letteryzzm/emotionbot/docs/项目版本与素材.md

# 项目版本与素材

> 2026-11-10：后续不使用 T5，输入改为电脑直连；模型选择与标定规划见[下一阶段方案](下一阶段方案-上位机情绪识别与标定.md)。以下代码整合记录保留历史来源，实时流程尚未按新方案改造。

## 当前代码与运行入口

原有未提交的视觉、戏台、总控、T5、标定、固件、测试和 PPT 生成脚本已纳入版本控制，并合并远端感知 / 决策 / 运行时。原始工作区完整保存在提交 `26802ea`，便于追溯；后续合并保留串口启动重试与中心补偿，依赖配置同时包含两套模块。

两套运行入口仍各自独立；代码归入同一仓库不代表完整真机链路已统一验收。模型、数据、原始演示素材仍在 T9。此次只做软件测试与仿真验证，未重刷固件或驱动真机。

## 整理前的版本边界（历史快照）

| 来源 | 基线 | 内容 |
|---|---|---|
| [GitHub main](https://github.com/letteryzzm/emotionbot/tree/21aab03e8e861636405590df0e3fdff7665b93ec) | `21aab03`，通过 `git ls-remote` 核实 | 固件 / 电脑端基础、感知 / 决策 / 运行时、六份项目与联调记录 |
| T9 工作树 | HEAD `e2b0061`，落后 main 六个提交，另有未提交改动 | camera、culture、lingmou、T5 EB2、标定工具、现场素材，以及既有固件 / 电脑端修改 |
| note/head | 原有笔记与此次汇入 | 学习记录、研究综述、硬件图解、协议、日志、评测报告与素材索引 |

第一轮先发布文档，保留原 T9 工作树的未提交代码；随后用户要求把原有未提交内容一并提交，因此完成上述代码合并。表中的提交号只描述整理前状态。

## Demo 原件

以下均相对 T9 项目根目录；时长取自现有文件的 ffprobe 元数据。

| 文件 | 时长 / 大小 | 内容与去向 |
|---|---|---|
| `ppt/assets/V1_主视频.mp4` | 65.876 s / 32.8 MiB | 主 Demo；完整视频留 T9，封面用于 README |
| `ppt/assets/V2a_红脸.mp4` | 3 s / 519 KiB | 红脸动作；精选副本 [opera-red.mp4](media/opera-red.mp4) |
| `ppt/assets/V2b_黑脸.mp4` | 3 s / 537 KiB | 黑脸动作；精选副本 [opera-black.mp4](media/opera-black.mp4) |
| `ppt/assets/V2c_蓝脸.mp4` | 3 s / 666 KiB | 蓝脸动作；精选副本 [opera-blue.mp4](media/opera-blue.mp4) |
| `ppt/assets/V5_学你.mp4` | 14 s / 4.1 MiB | 表情模仿；完整视频留 T9，封面用于 README |
| `ppt/IMG_0278.MOV` 等 | 最大约 2.3 GiB | 原始拍摄，不随笔记或 README 复制 |
| `ppt/08灵眸战队.pptx`、`08灵眸战队.pptx` | 两份现存演示稿 | 原件均保留；没有假定两份相同 |

`ppt/build_deck.js` 中“看见你”（V3）和“听你说”（V4）仍为视频预留位；不把预留位描述为已完成录像。

## README 配图来源

精选图片直接复制已有素材，没有生成替代实物图或改动原件。

| 当前文件（`docs/media/`） | 来源（`ppt/assets/`） |
|---|---|
| `demo现场.jpg` | `V1_cover.jpg` |
| `真机.jpg` | `P3_真机.jpg` |
| `控制台.jpg` | `slot/S5.jpg` |
| `组装.jpg` | `slot/P9.jpg` |
| `标定.jpg` | `slot/P10.jpg` |
| `红脸.jpg` / `黑脸.jpg` / `蓝脸.jpg` | `V2a_红脸_cover.jpg` / `V2b_黑脸_cover.jpg` / `V2c_蓝脸_cover.jpg` |
| `表情模仿.jpg` | `V5_学你_cover.jpg` |

## 大文件存放

本机 T9 挂载为 `/Volumes/Robotics`，项目位于 `/Volumes/Robotics/projects/head`。

| 位置 | 保存内容 |
|---|---|
| `ppt/` | 原始 MOV、剪辑、图片原件与演示稿，约 2.5 GiB |
| `models/` | 模型权重，约 590 MiB |
| `emo_bench/data/` | 评测数据，约 541 MiB |
| `upstream/` | 原作者 CAD、参考模型和下载包，约 417 MiB |
| `outputs/` | 渲染、缓存、日志等，约 204 MiB |
| `print_package/` | STL、3MF 和补打包，约 134 MiB |
| `机器人头_打印包.zip` | 完整打印压缩包，约 58 MiB |
| `.venv/` | 本机运行环境，约 364 MiB |

这些路径均保留原位。note 只新增文档、必要的小图和 HTML；评测报告中的视频链接回 T9，需要挂载磁盘。此清单不承诺文件已上传到 GitHub Release。

整理前的 README、四份被更新的 note 文件、原始 Git 差异和校验清单备份于同盘 `projects/head-整理备份-2026-11-09/`。它是回退副本，不是跨磁盘备份。
