letteryzzm/emotionbot/docs/舵机标定与表情交接-2026-11-07.md

# 舵机标定与表情交接

> 2026-11-07 14:58 的状态。机器人头 Will Cogley Robot Head α2.0.33，21 个舵机，三块 Pico 都插在 ROG 上。
> 这份接替 [下巴和嘴部测试交接.md](下巴和嘴部测试交接.md) 的流程。那份的舵机表和接线说明仍然有效。

## 一句话状态

硬件已装好，三块板在线。舵机正在逐组做 90° 和摆动测试，**还没有一个舵机标记为"通过"，也没有实测范围写回 config**。表情还不能跑。

**写这份文档时 UD 还通着电**，停在 90°。接手后先确认现场，不用时点"全部卸力"。

## 16:04 更新

用户明确放开了慢速和逐组限制：表情要一起动、幅度要大，不用管风险。调试台速度改为 300°/s，加了"一起做"和"全部轮播"。7 个表情已在真机轮过两遍，命令全部 `OK`、没有掉线。下面第 1 条的"逐组"只适用于标定时单个舵机的排查。

16:08：加了 `head/eye_motion.py`，每个表情有自己的眼部动作（眨眼、扫视、垂眼），调试台"一起做"和"全部轮播"都会播放。`EXPRESSIONS` 没动。数值是手估的，要对着实物调。

## 必须遵守

1. **不要让全部舵机一起通电。** 只能一组一组来，每组让现场的人看过再继续。不要跑 `scripts/demo_expressions.py`，不要发 `R`、`C`，标定完成前都不行。
2. **听到持续嗡嗡声就卸力。** 调试台按 `Esc` 或红色按钮；连不上调试台就断 5V。
3. **串口同一时间只给一个程序用。** 调试台运行时不要跑 `tune.py`、`servo_step.py`。
4. **不要碰 T5。** 端口 8765、8766 和 `usb-1a86…` 串口属于 T5 屏幕板，由另一个账号和会话在用。`1a86` 不是 SO-101 机械臂。
5. **保留作者的舵机命名。** L/R 不统一是已决定的事，不要改名。

## 怎么连上

| 项目 | 内容 |
|---|---|
| 控制电脑 | `ssh rog`，代码在 `/srv/robot-head` |
| 代码同步 | `/srv/robot-head` 不是 git 仓库。在 Mac 的 `/Volumes/Robotics/projects/head` 改，再 `scp` 过去 |
| 调试台 | ROG 上 `127.0.0.1:8770`，无登录验证，ROG 上其他账号也能访问 |
| Mac 访问 | `ssh -N -L 8770:127.0.0.1:8770 rog`，然后打开 http://localhost:8770 |
| 重启调试台 | `cd /srv/robot-head && setsid -f .venv/bin/python scripts/tune_server.py >> outputs/tune_server.log 2>&1 < /dev/null` |

重启调试台不会让舵机动，也不会卸力。重启后它不知道哪些舵机已经通电，页面上的"通电"会显示为无。

| 板 | 序列号后缀 | 舵机 |
|---|---|---|
| eyes | `e6616407e368822b` | UD LR BL TL TR BR |
| brows | `e6616407e3689e2a` | LI RO LO RI |
| mouth | `e6616407e380b62c` | JL JR LUL LUR LLL LLR CUL CUR CLL CLR TON（EXA 没接） |

认板靠 `?` 回的 `ROLE`，不靠 ttyACM 编号。三块板都已确认是新固件：开机不发信号。

## 工具和文件

| 文件 | 作用 |
|---|---|
| `scripts/tune_server.py` | 网页调试台：逐组通电、回 90°、摆动 ±15 / ±30、小步转动、记录现象 |
| `outputs/tune_log.jsonl`（ROG 上） | 全部命令和现象的原始日志 |
| `scripts/build_tune_log.py` | 拉取日志，生成 `docs/表情调试日志.html` |
| `docs/舵机标定图.html` | 每组 90° 时应有的位置，带可信度；生成脚本 `scripts/assembly_render/calib_html.py` |
| `scripts/tune.py` | 命令行单步工具，调试台运行时不要用 |
| `tests/test_tune_server.py` | 调试台安全规则的假硬件测试 |

调试台在服务端强制这些规则：不提供 `R`、`C`；小步最多 5°；不超出 config；没通电不能转；JL + JR 偏离 180 不超过 5°；通一组时其他板卸力。

串口断开时页面报警，板子回来后自动发 `X`。这是因为 USB 断开时 Pico 可能靠 5V 继续跑，舵机还在受力。

## 测试进度

下表只来自日志。"已运行"只说明命令发出去并回了 `OK`，**不代表动作正确**：舵机没有位置反馈，14:30 之后日志里没有新的现象记录。

| # | 组 | 已运行 | 现象记录 |
|---|---|---|---|
| 1 | TON | 通电到 90° | 无 |
| 2 | LLL / LLR | ±15、±30 多次，走到 60–110 | 无 |
| 3 | CLL / CLR | ±15、±30，单向走到 120 / 65 | 无 |
| 4 | JL / JR | ±15、±30，单向走到 60 / 120 | 无 |
| 5 | CUL / CUR | 只通电到 90° | 无 |
| 6 | LUL / LUR | 只通电到 90° | 无 |
| 7 | LO / RO | ±15、±30；曾接线交叉 | 用户报告已改好，待复测 |
| 8 | LI / RI | ±15、±30；曾接线交叉 | 用户报告已改好，待复测 |
| 9 | BL / BR | 只通电到 90° | 无 |
| 10 | TL / TR | 只通电到 90° | 无 |
| 11 | LR | ±30，走到 120 和 60；这次没做 ±15 | 无 |
| 12 | UD | ±15，走到 105 和 75 | **未解决**：90° 时向下看约 30°，用户两次报告 |

## 未解决的问题

**1. 最高优先级：UD 在 90° 时眼睛向下看约 30°。** 用户 14:30 报告，修完眉毛后再次确认还在，并要求一直记录：眼睛的转动最传神。修好之前，所有表情的眼部都不算数。这 30° 是目测的眼球角度，不是舵机角度，连杆比例未知。官方标准是两眼朝前、舵盘臂朝正上，所以这是真问题。用户决定走软件补偿，直接按 30° 写入：`head/centers.json` 里 UD 中心 120°，调试台和 `head/actuators.py` 都按它算，上限 140，所以向上只剩 20°。这个值假设连杆 1:1、角度增大向上，都没实测，要现场确认眼睛是否正对前方。推测是舵盘齿位错了，要拆下来换齿，不要靠改角度补偿。UD 的压扣和拆法见 `docs/眼部传动与组装.html`。还要确认断电时手拨眼球能否回到正前方。

**2. 嗡嗡声来源没有确认。** 听到过两次：第一次是 22 个通道一起到 rest 之后，第二次在 UD 通电时。UD 是嫌疑最大的，但还没证实。之后有没有再响没有记录。

**3. 14:29:55 整个 USB Hub 掉线 11 秒。** 三块 Pico 和 Hub 上的网卡一起掉线，原因不明：可能是有人动了线，也可能是舵机堵转拉低电压。现场还没回答。调试台 14:50 重启后到写文档时没有掉线报警。

**4. 左右方向没有验证。** `head/actuators.py` 的 `ANGLE_UP_IS_CCW` 还是 `True`。需要现场回答：`LR` 角度变小时，眼球转向面对机器人的左手边还是右手边？按现在的假设是左手边。反了要改成 `False` 并整体对调。

**5. config 已按用户要求加大，但不是实测值。** 16:03 把眉毛（65–135、45–115）、下巴（张到 35 / 145）、嘴角（笑到 45 / 120，宽到 135 / 50）、UD（60–160）写进三块 Pico，只换了 `config.py`，`main.py` 没动。用户明确说不用怕舵机坏，要表情更明显。实测范围目前一条都没有，所以 `head/hub.py` 还不会驱动舵机。

**6. 固件隐患没修。** 详见 [固件协议测试记录-2026-11-06.md](固件协议测试记录-2026-11-06.md)：畸形输入会让主循环退出；`S` 边解析边生效；`V` 没有上限；`O` 的 90° 是瞬跳。调试台绕开了前三个，第四个还在。

**7. 眉毛接线（已由用户修好，待确认）。** 曾经左侧 GP8、GP9 对调：LO 和 RI 一起动、LI 和 RO 一起动。用户 15:18 之后报告"改好了"，具体改法没有记录。如果不是按接线图改的，要更新 `docs/眉毛板杜邦线接线图.html`。复测第 7、8 组：第 7 组两边外侧动，第 8 组两边内侧动。

**8. 眉毛板 USB 反复掉线。** 15:13–15:17 之间调试台 6 次重连并卸力。多半是改线时动到了，没有确认。如果不再改线时还掉，要查 USB 线和供电。

## 关键事实

- **舵机读不到真实角度。** `G` 和页面上的角度只是最后命令值。断电重启后固件记录全部回 90，和实物无关。
- **回初始状态不需要读角度。** 舵机内部闭环，发固定角度就回到同一个物理位置。问题只在卸力后第一下：固件先写跟踪值，这一下不限速。
- **90° 不适合当 home。** 眼皮、下巴、嘴角前后的 90° 都在行程端点，眼皮还是闭着的。
- **标定标准可信度不一样。** 眼部有官方说明；下巴和嘴角前后来自项目约定；舌头、嘴唇、嘴角上下、眉毛没有来源写明 90° 的绝对位置，只能看对称和是否顶住。模型的姿态没有标明对应哪个角度。

## 下一步

1. 现场回答问题 2、3、4，把已跑过的组的现象补进日志。页面上写完要点"通过 / 有问题 / 记一下"才会保存。
2. 修 UD：断电，拆舵盘换齿，再用调试台确认 90° 朝正前。
3. 继续没摆动过的组：TON、CUL/CUR、LUL/LUR、眉毛、眼皮，先 ±15 再 ±30。LR 补一次 ±15。
4. 每组记实测范围，改 `firmware/config_*.py`，只收顶死的一端，留 5° 余量。JL、JR 保持镜像。改完断 5V 重刷，跑 `pytest`。
5. 定 home 姿态。用户还没决定，建议是眼睛睁开朝前、嘴闭合、眉毛放松。
6. 做 home 机制（都还没写）：电脑保存最后命令值；固件加一条命令，通电前先设跟踪角度；动作前逐组慢速回 home。固件改动要重刷三块板，刷之前断 5V。
7. 逐个调表情。在调试台"保存姿态"，页面的表情部分会记录步骤，用来最后演示一个表情是怎么做出来的。第一张照片发来时，再给日志页加图片支持。
8. 之后才是 `scripts/mimic.py`。

## 用户的工作方式

- 用户看实物，报"朝哪个方向偏了多少"，左右按面对机器人说。
- 任何让舵机动的命令，先说清楚要动哪个、动多少。
- 现场说停就停。卸力除外的命令都不要再发，等用户恢复。
- 网页和报告只放本地，不发布到 claude.ai。

## 提交状态

都在 `main` 上，**没有提交**：`scripts/tune.py`、`scripts/tune_server.py`、`scripts/build_tune_log.py`、`scripts/assembly_render/calib_html.py`、`tests/test_tune_server.py`，以及 `docs/` 里的 `舵机标定图.html`、`表情调试日志.html` 和这份文档。

仓库里还有别人未提交的 T5 和摄像头改动（`camera/`、`firmware_t5/`、`head/t5_*.py` 等），提交时不要混进去。

全量假硬件测试 148 个通过，其中 17 个是调试台的。回 90° 和摆动已在真机上运行，但动作是否正确要看现场记录。
