letteryzzm/emotionbot/docs/复现计划.md

# Will Cogley 机器人头 α2.0.33 复现计划（用于机器人情感学习）

> 2026-10-14 · 代码和 CAD 在 ``，本目录只放笔记
> 背景调研见同目录 `情感计算×脑机接口×机器人调研报告.md` 第 5.3 节方案 B

## 1. 这个头是什么

| 部分 | 舵机 | 控制板 | 原版代码 |
|---|---|---|---|
| 眼睛 | 6 个：眼球左右 LR、上下 UD，四片眼皮 TL/BL/TR/BR | Eyes_Brow_Neck PCB + Pico | `eyes.py` |
| 眉毛 | 4 个：左外 LO、左内 LI、右内 RI、右外 RO | 同一种 PCB 再做一块 + Pico | `Brows.py` |
| 嘴 | 11 个：下颌 JL/JR（MG996R），上下唇 LUL/LUR/LLL/LLR，嘴角 CUL/CUR/CLL/CLR，舌头 TON；另有一路没用到的备用口 EXA | Mouth Board PCB + Pico | `Mouth.py` / `MouthMaster.py` |

一共 **21 个舵机（19 个 MG90S + 2 个 MG996R），3 块树莓派 Pico**，没有脖子。这和官方页面写的"21 actuators"一致，见 4.1。

电路板（从 EasyEDA 文件里读出来的）：
- **Mouth Board**：Pico 插座、6 组 2×3 舵机排针（共 12 路）、AMS1117-5.0 给 Pico 供电、1000µF 和 220µF 滤波电容、SS1045 二极管、两个 Qwiic（1mm 4P）接口。
- **Eyes_Brow_Neck**：Pico 排针、L78M05 稳压、SS34 二极管、**12V / 5V 供电选择**、两个 Qwiic 接口。眼睛和眉毛各用一块。
- 3 块板之间用 Qwiic 线相连，但并**不是 I²C**：嘴部 Pico 把 GP16/17 当成 2 个数字位，给眼部和眉部板各发 4 种状态。

打印文件：`BambuPrintfile.3mf` 有 8 个 plate，直接用 Bambu Studio 打开。

## 2. 原版直接拿来做情感学习的问题

1. **电脑只能发离散命令**。电脑只连嘴部 Pico，眼睛和眉毛只能收到 2 个 bit，也就是 4 种状态（睁、闭、随机动；上、下、"开心"、"生气"）。没法连续控制视线、眼皮和眉毛，也就没法做表情学习。
2. **缺 `servo.py`**。原版 `from servo import Servo` 依赖的库不在压缩包里。
3. **`Mouth.py` 跑不起来**：第 104 行的 `for` 循环体全被注释掉了，报 `IndentationError`。实际能用的是 `MouthMaster.py`。
4. `HeadControlUI.py` 把串口写死成 Windows 的 `COM16`。
5. 眼部的 `eyes.py` 里写了电位器缩放和眼皮限位修正的函数，但都没被调用（标题写着 CONDENSED BOARD VERSION，像是从带旋钮的版本删过来的）。

## 3. 我做的改造（已完成，16 个测试通过）

位置：``

```
upstream/Head_α2.0.33/   原版文件的拷贝（CAD、PCB、代码）
firmware/                新固件：三块 Pico 刷同一份 main.py，只有 config 不同
  main.py servo.py config_eyes.py config_brows.py config_mouth.py flash.sh
head/                    电脑端 Python 包
  actuators.py           22 维动作空间，u ∈ [0,1]，直接读固件 config
  client.py              自动找串口、按名字或向量下发
  expressions.py         7 种基本表情（按 FACS 的 AU 设计）+ 混合
  blendshape_map.py      MediaPipe 52 个 blendshape → 舵机（22 维向量，含没用到的 EXA）
  viz.py                 2D 卡通脸预览，没硬件也能调
scripts/demo_expressions.py  轮播表情（--viz 只画图）
scripts/mimic.py             摄像头表情模仿，--record 存 (blendshape, u) 数据
tests/                   在 CPython 里用假硬件跑固件逻辑
```

**关键改动：每块 Pico 各接一根 USB 到电脑**（用一个 USB hub），不再走 2-bit GPIO。这样硬件不用改，电脑可以连续控制全部 21 个舵机。

串口协议（115200 波特率，每行一条命令）：

| 命令 | 作用 |
|---|---|
| `?` | 返回这块板是 eyes / brows / mouth，以及它管的舵机名 |
| `S LR=90 UD=100` | 设置目标角度，超出 config 范围的会被截断 |
| `G` | 读取当前角度 |
| `V 300` | 设置最大转速（°/s），固件会做限速插值，表情过渡更自然 |
| `R` / `C` / `X` | 回到 rest / 全部 90°（装舵盘时用）/ 卸力 |

动作空间：每个舵机一个 u ∈ [0,1]。u=0 和 u=1 分别对应 config 里的角度 a 和 b，含义统一成"睁眼程度、眉毛抬起程度、张嘴程度、嘴角上扬程度……"。学习算法只需要面对一个 22 维的 [0,1] 向量。

角度范围是从原版的 poses 和 servo_limits 里取的。**每个舵机的方向和范围都要装好后对着实物再标定**，改 `firmware/config_*.py` 就行，电脑端会自动跟着变。

7 种表情的 2D 预览：`outputs/expressions.png`

## 4. 复现步骤

### 4.1 采购（全部网购，价格是估算）

**官方 BOM**（[Nilheim Notion：Robot Head α2.0.33](https://www.notion.so/nilheim-mechatronics/Robot-Head-2-0-33-1d724779b64d80568fd9cf1c7abd3e64)）：
真实感眼球（NMRobots 卖）、2 个 MG996R、19 个 MG90S、M2/M3/M4 螺丝（有的舵机要 M2.5）、约 25 个 M3 台阶螺丝、约 10 个 M4 台阶螺丝、热熔螺母、50×50×10 mm 风扇、5V 10A 电源、Pico 控制板。官方页面明确说这是**半成品项目，BOM 和设计可能有错，文档很少**。官方页面只有 BOM 和下载包，没有逐步装配说明，装配靠参考装配模型和原作者的视频。

舵机位置是我从装配模型里逐个定位出来的，和代码里的通道对得上：

| 位置 | 数量 | 型号 | 通道 |
|---|---|---|---|
| 眼睛（眼球和眼皮） | 6 | MG90S（CAD 里画的是外形一样的 SG90） | LR UD TL BL TR BR |
| 眉毛 | 4 | MG90S | LO LI RI RO |
| 嘴唇、嘴角、舌头 | 9 | MG90S | LUL LUR LLL LLR CUL CUR CLL CLR TON |
| 下颌 | 2 | **MG996R** | JL JR |

**舵机怎么选：**
- **MG90S 全部用金属齿版，180°，统一买同一家同一批。** 外形和 SG90 一样（约 23×12×29 mm），但扭矩更大，齿轮不容易打坏。
  - 打印件里有舵盘适配件，不同厂家的花键齿数和舵盘尺寸可能不一样，混买容易装不上。
  - 买 19 个加 4 到 6 个备件。买到后称一下，正品约 13 到 14 g；太轻的多半是塑料齿冒充的。
- **MG996R 用在下颌**，带动整个下巴，需要大扭矩。可以升级成 DS3218，同样是标准尺寸、扭矩更大、死区更小，下颌抖动会少一些。但官方是按 MG996R 设计的，**第一台建议先用 MG996R**。
- **不要买 270° 或连续旋转版**，也不要买数字舵机的"360°"版。
- 这类 PWM 舵机没有位置反馈，学习时靠摄像头看脸来闭环，见第 5 节 L2，所以不需要买总线舵机。
- 全部 21 个舵机都接 5V，MG996R 在 5V 下也能用（工作范围 4.8 到 7.2V）。

| 物品 | 数量 | 备注 |
|---|---|---|
| Raspberry Pi Pico（不带 W） | 3（多买 1） | |
| MG90S 金属齿 180° | 19 + 4 到 6 个备件 | 淘宝约 ¥8 到 15 一个 |
| MG996R | 2 + 1 个备件 | 约 ¥20 到 35 一个 |
| 5V 10A 电源（推荐适配器 + DC 母头转端子） | 1 | 官方要求；USB-C 只能给 5V 3A，不够用。图解见 `电源与接线.md` |
| XT60 **公头**线 1 根、XH2.54 2P 线 2 根 | — | 分别给嘴部板和眼部 / 眉部板供电。嘴部板上焊的是 XT60 母座（XT60PW-F），所以线要配公头 |
| 螺丝、螺母、热熔螺母 | 见下方螺丝清单 | |
| 50×50×10 mm 5V 风扇 | 1 | |
| 眼球 | 2 | 官方建议买 NMRobots 的真实感眼球（£25 起，经常缺货）。先用打印包第 9 盘的打印眼球代替 |
| USB hub 和 3 根 micro-USB 数据线 | 1 套 | 新方案每块 Pico 都要连电脑 |

**螺丝清单**

> 2026-10-31 更新：已经从装配模型里逐颗量过孔径，热熔螺母规格、每颗螺丝的用途和清点表见 `螺丝与热熔螺母清单.md`，以那份为准。下表保留作参考。

数据来源：规格和长度来自参考装配模型里的零件名，台阶螺丝的尺寸是我按模型实测的。

装配模型画得不全，比如右侧眉毛机构就没画。官方写的是"约 25 个 M3 台阶螺丝、约 10 个 M4 台阶螺丝"，而模型里分别只有 14 个和 4 个。所以建议购买量按模型数量的 1.5 到 2 倍给，台阶螺丝按官方数量再多买几个。

| 规格 | 模型里的数量 | 建议买 | 推测用途 |
|---|---|---|---|
| **M3 台阶螺丝（轴肩螺丝）**：螺纹 M3、长约 4 mm；轴肩直径 4 mm、长 4 mm；头部直径 6 mm、高 3 mm | 14 | **30** | 嘴部连杆、嘴唇的转轴 |
| **M4 台阶螺丝**：螺纹 M4、长约 4.5 mm；轴肩直径 5 mm、长 5 mm；头部直径 8 mm、高 4 mm（模型里的型号是 SSHE-M4-5-5） | 4 | **12** | 下颌转轴 |
| M2×6 内六角圆柱头 | 22 | 40 | 数量最多，推测用来固定 MG90S |
| M2×8 内六角圆柱头 | 2 | 10 | |
| M2.5×8 内六角圆柱头 | 8 | 16 | 穿过嘴部连杆拧进 MG90S 输出轴（已核实，不是固定 MG996R）；舵机输出轴是 M2 的话换 M2×8 |
| M3×6 内六角圆柱头 | 8 | 20 | |
| M3×8 内六角圆柱头 | 8 | 20 | |
| M3×10 内六角圆柱头 | 6 | 15 | |
| M4×6 内六角圆柱头 | 2 | 6 | |
| M4×8 内六角圆柱头 | 4 | 10 | |
| M4×16 内六角圆柱头 | 6 | 12 | |
| M4 热熔铜螺母：外径 5.6 到 6.0，长 5 到 6 mm（孔 Ø5.35，最浅孔深 6 mm） | 16 | 20 | 下颌、颧骨、TopBase |
| M4 平垫、M5 平垫 | 各 1 | 各 10 | |
| M2 热熔螺母（孔 Ø3.2）/ M3 热熔螺母（孔 Ø4.4） | 16 / 22 | 各 50 | 外径 3.5 / 4.8 到 5.0 |
| M3 普通六角螺母 | 14 | 30 | 嘴唇零件上有螺母槽，M3 台阶螺丝拧进去；槽深约 2.6 mm，尼龙防松螺母放不进 |

购买建议：
- 内六角螺丝直接买 **M2、M2.5、M3、M4 的 304 不锈钢内六角圆柱头套装盒**（每种规格都有 6、8、10、16 mm 这几个长度），比按单个规格买省事，也不怕漏。
- 台阶螺丝在淘宝搜"轴肩螺丝 / 塞打螺丝"，按上面的轴径、轴长、螺纹规格选。
- 热熔螺母的外径以打印件上的孔为准。打印件到手后先用卡尺量一下孔径再下单。
- 舵机自带的自攻螺丝和舵盘螺丝也留着，装舵盘时会用到。

舵机、Pico、PCB、元件、电源和螺丝加起来估计 **¥600 到 ¥900**，打印另算。

### 4.2 打印（找人代打）

**发给打印的人：** `机器人头_打印包.zip`（60MB）。里面有：

- `BambuPrintfile.3mf`：原作者已经分好盘、设好参数，对方有拓竹打印机就直接用这个。
- `STL/`：按盘分目录，每个零件一个文件，已经摆好打印方向。文件名格式是 `零件名__x数量__材料.stl`，对方用别的打印机也能打。
- `预览图/`：每个盘的效果图，用来核对。
- `打印说明.txt`：材料、参数和各盘内容。

| 盘 | 内容 | 件数 | 材料 |
|---|---|---|---|
| 1 外壳 | 后盖、前后格栅 | 3 | PLA 白 + 灰 |
| 2 嘴部机构 | 上下颌座、嘴唇、连杆 | 27 | PLA |
| 3 主框架 | 头骨框架，153×156×180 mm，最大件 | 1 | PLA |
| 4 眉毛 | 眉毛主体和连杆 | 13 | PLA |
| 5 眉毛软件 | 2 个软件 | 2 | **TPU，必须用软料** |
| 6 框架附件 | 颧骨、风扇支架 | 2 | PLA |
| 7 眼部机构 | 底座、眼皮、连杆、舵盘适配件 | 30 | PLA |
| 8 牙齿舌头 | 牙齿、牙龈、舌头，层高 0.1 mm | 5 | PLA 白 + 粉 |
| 9 补充 | 眼球 ×2（如果不买官方眼球就打）、额头装饰条 ×1（可选） | 3 | PLA 白，层高 0.1 mm |

- 参数：层高 0.2 mm，6 层墙，25% 填充，树状支撑。
- 实体体积约 880 cm³，耗材估计 0.8 到 1 kg。
- **第 9 盘不在原作者的 3mf 里**，因为官方用的是买来的眼球。我从装配模型里导出了眼球的外形（直径 32 mm 的半球），可以打印出来代替。
- 装配模型下颌两侧的两个方块就是 MG996R。还有一个直径 21 mm、厚 2 mm 的圆片，也是外购件，没有放进打印包。

### 4.3 电路板：在嘉立创下单，自己焊

从 EasyEDA 文件里核对出来的供电路径：

- **嘴部板**：XT60 输入 **5V** → SS1045 二极管 → 12 路舵机电源；同时经过 AMS1117 → 跳线 → Pico。
- **眼部 / 眉部板**：XH 2P 输入 VIN → SS34 二极管 → 6 路舵机电源；同时经过 L78M05 → Pico。舵机电源**直接接在 VIN 上**，所以虽然板上写着 12V Select，**也只能接 5V**，接 12V 会烧舵机。
- 三块板都接同一个 5V 电源。Pico 同时插着 USB 也没问题，Pico 内部的 VBUS 有二极管隔离。

#### 下单 PCB（嘉立创）

文件在 `pcb/`，有两个 `.epro` 工程，外加一份合并好的元件 BOM。

| 板子 | 尺寸 | 数量 | 规格 |
|---|---|---|---|
| Eyes_Brow_Neck（眼眉板） | 26.7 × 62.5 mm | 需要 2 块（眼睛、眉毛各 1 块） | 双层板 |
| Mouth Board（嘴部板） | 72 × 55 mm | 需要 1 块 | 双层板 |

两块都是 10×10 cm 以内的双层板，打样很便宜，嘉立创经常有免费打样券。每种起订 5 块，多出来的当备件。

步骤：
1. 安装**嘉立创 EDA 专业版**（客户端，或网页版 pro.lceda.cn），登录嘉立创账号。
2. 用"文件 → 打开 / 导入"打开 `.epro`，进入 PCB 页面，先跑一遍 DRC 设计检查。
3. 选顶部菜单的"下单 → PCB 下单"，会直接跳到嘉立创下单页并自动带上制板文件。也可以选"导出 → PCB 制板文件（Gerber）"，再到 jlc.com 手动上传。
4. 下单参数：
   - 层数 2，FR-4，板厚 1.6 mm，铜厚 1 oz，数量 5，不需要拼板。
   - 表面处理选有铅喷锡，手焊最好上锡；无铅也可以。阻焊颜色随意。
   - **不要选 SMT 贴片**，自己焊。
   - 原因：板上元件几乎都是嘉立创的"扩展库"器件，每种扩展器件要单独加换料费，贴片反而比自己焊贵很多。
5. 两个工程分开下单，各 5 块。

#### 买元件（立创商城）

用 `pcb/立创商城BOM_3块板合计.csv`，已经按"2 块眼眉板 + 1 块嘴部板"把数量合计好，也加了备件。在立创商城（szlcsc.com）搜立创编号加入购物车，或者用"BOM 配单"上传这个文件。

表里"必需 = 否"的可以不买：
- 原版两板互联用的 1 mm 接口，本方案用不到。
- 指示灯和它的电阻，只是电源指示。
- 眼眉板上的 L78M05 和它的钽电容，只在接 12V 时用。

几个和原版不同的地方：
- **眼眉板的 Pico 插座**：原版用的是 1x20 排针，Pico 要直接焊上去。我改成 1x20 **排母**，配带排针的 Pico H，坏了可以直接拔下来换。排母在淘宝买就行。嘴部板原版就是排母，不用改。
- **眼眉板的供电选择**：板上有两个不放元件的 0805 焊盘，C11 标着"12V Select"，C12 标着"5V Select"。
  - 不是电容，是选择输入电压的跳线。
  - 本方案接 5V，**C12 用焊锡短接（或焊一个 0805 0Ω 电阻），C11 空着**。
  - 不短接的话，板子不会给 Pico 供电。插着 USB 时还能用，拔掉 USB 就不工作了。
- **嘴部板的 BOARD POWER**：一个 2P 排针，插上跳线帽，板子才会给 Pico 供电。

Pico 同时接板子电源和 USB 是安全的。Pico 板载有一个 VBUS 到 VSYS 的二极管，板子的 5V 不会倒灌回电脑的 USB 口。

**焊接难度：可以自己焊。** 贴片元件大多是大封装：

| 难度 | 元件 |
|---|---|
| 简单 | 插件排针 / 排母、拨动开关、XT60、XH 接口；SMD 电解电容（6.3 mm 和 10 mm）；SOT-223 的 AMS1117；TO-252 的 L78M05；SMB / SMA 二极管；1206 电阻 |
| 中等 | 0805 电容 ×2、钽电容（**注意极性**）、0603 指示灯（可以不焊） |
| 不用焊 | 两个 1 mm 间距的 SH 4P 接口（CN1、CN2）：只用于原版两板互联，新方案每块 Pico 各接一根 USB，用不到 |

工具：尖头烙铁、0.6 到 0.8 mm 焊锡丝、助焊膏、镊子、万用表。焊完先**不插 Pico、不接舵机**，用万用表量 5V 和 GND 之间没有短路，再上电测舵机电源和 Pico 供电的电压。电解电容、钽电容和二极管都有极性，按丝印方向焊。Pico 建议用排母插接，坏了方便换。

### 4.4 刷固件和调试（按这个顺序，不要一次装完再上电）

```bash
source /Volumes/Robotics/env.sh && cd /Volumes/Robotics/projects/head
# 1. 每块 Pico：按住 BOOTSEL 插 USB，把 MicroPython 的 .uf2 拖进去
# 2. 刷新固件（一次只插一块）
firmware/flash.sh eyes      # 再分别刷 brows、mouth
# 3. 装舵盘之前：发 C 让全部舵机转到 90°，在 90° 位置装舵盘和连杆
.venv/bin/mpremote connect auto repl   # 然后输入 C 回车
# 4. 逐个舵机标定方向和范围，改 firmware/config_*.py 后重刷
# 5. 三块都插上，跑表情轮播
.venv/bin/python scripts/demo_expressions.py
```

## 5. 情感学习路线

| 阶段 | 做什么 | 依赖 | 对应工作 |
|---|---|---|---|
| L0 | 手工表情 + 2D 预览 | 已完成 | — |
| L1 表情模仿 | 摄像头看人，MediaPipe 出 blendshape，手写映射驱动舵机 | `scripts/mimic.py`，需要装 `.[vision]` 并下载模型 | 报告 5.3 方案 B |
| L2 学习自我模型 | 让机器人随机动舵机（motor babbling），另一个摄像头拍**它自己的脸**跑 MediaPipe，得到 (u, blendshape) 数据对。训练逆模型 blendshape → u，替换手写映射 | 第二个摄像头对准机器人 | Columbia Eva / Emo（Science Robotics 2024）的核心做法 |
| L3 感知到表达的闭环 | SenseVoice / emotion2vec（语音）+ 人脸情绪识别 → LLM 决定回应的表情和强度 → 机器人头 | 报告第 2、3 节的模型 | 调研报告里提到的"闭环评估"空白 |
| L4 用人的反馈优化 | 人对表情打分或做两两比较，用偏好学习或 RL 优化表情；进阶版把 ErrP 当奖励 | L3 + 用户实验 | HAPI；报告课题 1 |
| L5 提前预测表情 | 根据人脸前几百毫秒的变化，预测对方马上要笑，提前同步笑 | L2 的逆模型 + 时序模型 | Emo 的"提前约 840ms 预测微笑" |

**建议的第一个小目标**：做完 L1 和 L2，对比"手写映射"和"学到的逆模型"在表情模仿上的误差。评价方式是用 MediaPipe 分别处理人脸和机器人脸，比较两边 blendshape 的距离。这一步数据自己能采，不依赖别人，结果也容易量化。

## 6. 还没确认的事

- 舵机型号和数量已经和官方 BOM 对上（见 4.1）。官方没有逐步装配说明，装配只能看参考装配模型和原作者的视频。
- 供电已经从网表核对过（见 4.3）：三块板都用 5V。
- `EXA` 这一路在原版里没用到，不知道接的是什么。
- 新固件和 blendshape 映射只在电脑上用假硬件测过，`mimic.py` 还没在真摄像头上跑过。
- 许可证：Nilheim 页面说可以自由使用和修改，但没写具体协议。发论文或开源前要确认。

## 7. 待重打印（找朋友打）

| 日期 | 零件 | STL | 打几个 | 备注 |
|---|---|---|---|---|
| 2026-11-01 | 眼皮舵盘 4xTopLidHorn | `print_package/STL/plate7_Eyes/4xTopLidHorn__x4__PLA-灰.stl` | 3（1 个补 + 2 个备用） | 装眼部时弄坏 1 个。舵盘薄，建议 100% 填充 |

| 2026-11-01 | 颈部支架（自己画的，原版没有） | `print_package/给朋友打印_2026-11-01/NeckStand_颈部支架_x1.stl` | 1 | 底板平放，加 brim；用 2 根扎带穿立柱上的孔固定到头骨框架底面横梁 |
| 2026-11-01 | 官方眼球（EyeMech ε3.2 里的 Component74） | 同目录 `Eyeball_官方_x2.stl` | 2 | 白色，0.1 mm 层高 |
| 2026-11-01 | 舵机尺寸测试块 ServoSizingPlate | 同目录 | 1 | 测眼部舵机座的松紧 |

整包（含打印说明、预览图）：`print_package/给朋友打印_2026-11-01.zip`
