letteryzzm/emotionbot/docs/表情标定闭环.md

# 表情标定：调整、保存、重启与标签调用

2026-11-11：现有调试台已支持分组叠加控制、七类表情持久化、加载预览、重放和情绪标签 API。标定台是此流程的唯一串口所有者；识别模块通过 HTTP 调用它。无需 T5。

软件流程已经可运行，真实机器的七类表情仍需要人工调整和确认。历史日志、旧版预设及仿真姿态不会自动成为真机标定。

> 2026-11-13 当前状态：按用户明确要求，LLR 已恢复普通手动标定，可单独、成对或加入自选组测试；EXA 仍禁用。历史临时隔离和声音观察见 [LLR 交接](LLR-90度异响排查-2026-11-11.md)。权限恢复不等于机械验收通过。

## 启动

在项目根目录运行，浏览器访问 `http://127.0.0.1:8770`：

```bash
# 仿真：不打开串口，不修改真实中心配置
.venv/bin/python scripts/tune_server.py --sim

# 真机：先关闭 hub、app.run、tune.py 等其他串口控制程序
.venv/bin/python scripts/tune_server.py
```

真机启动只读取板子的控制角度，不自动通电、不加载动作。点击“通电并手动调节”“仅做 90° 检查”“慢速重放”等动作按钮才发送动作。设备断开后重新接入时会自动卸力。

从 Mac 操作 ROG 上的服务：

```bash
ssh -N -L 8770:127.0.0.1:8770 rog
```

然后在 Mac 打开同一地址。ROG 部署目录是 `/srv/robot-head`。服务只监听本机回环地址，使用 SSH 转发访问。

2026-11-11 已在 ROG 启动 `emotionbot-calibration.service`（用户级临时服务，未设置开机自启）：

```bash
ssh rog 'systemctl --user status emotionbot-calibration.service'
ssh rog 'systemctl --user stop emotionbot-calibration.service'
# 临时服务停止或重启 Linux 后，重新创建：
ssh rog 'systemd-run --user --unit=emotionbot-calibration --property=WorkingDirectory=/srv/robot-head /srv/robot-head/.venv/bin/python /srv/robot-head/scripts/tune_server.py'
```

停止服务会中断任务并向在线板子卸力。也可以直接在 ROG 终端使用前面的 Python 命令运行。

## 标定操作顺序

2026-11-13 已换为[标定台 v2](舵机标定台-v2.md)：选择单个 / 成对 / 自选组 → 通电并手动调节 → 慢速滑块调整 → 位置与观察记录。90° 检查是可选项，人工观察不再限制滑块权限。Esc 随时卸力，连接中断触发会话超时卸力。

1. 选好本套表情参与的通道，点击“通电并手动调节”后慢速调整为中性位置；LLR 可正常加入组合，下巴必须成对。
2. 展开页面下方“七类表情库”，保存 neutral。它定义通道集合；位置记录与表情库是两份数据。
3. 继续调整同一组电机，分别保存 happy / sad / angry / fear / disgust / surprise。每类使用与 neutral 相同的通道集合。
4. 预览只显示角度，不驱动电机。结束手动会话并卸力后，可通过“慢速重放”验证已保存表情；页面设定 5 秒过渡，标签 API 仍支持强度与保持时间。
5. 使用相同文件路径重启，确认库恢复，再进行人工重放比较。页面角度来自 Pico 控制状态，没有实际轴角反馈。

修改 neutral 角度 / 通道集合或中心 / 硬件配置后，旧表情可能失效，需按提示重新标定。配置限位及已记录正式范围仍有效。旧版预设、跟踪与分组按钮不再占据新页面；对应旧接口尚保留供历史调用。

## 保存位置与备份

| 内容 | 默认路径 |
|---|---|
| 位置与观察库 | `calibration/expressions-positions.json` |
| 真机表情库 | `calibration/expressions.json` |
| 仿真表情库 | `outputs/calibration-sim/expressions.json` |
| 真机过程日志与实测范围 | `outputs/tune_log.jsonl` |
| 仿真过程日志 | `outputs/tune_sim.jsonl` |
| 真实中心配置 | `head/centers.json` |

可用 `--library PATH --log-file PATH --port 8771` 指定独立环境；重启要保持相同路径。仿真库带有 `mode: sim`，真机模式拒绝读取，防止误用。

每次保存递增 `revision`，使用临时文件和原子替换，写入失败保留旧库；并检查页面版本及磁盘变更，避免旧副本覆盖新结果。这里的版本号用于一致性检查，历史回退通过 Git 或备份完成。页面“导出表情库 JSON”可下载备份。真机标定完成后，应将此小文件和对应中心配置同步回代码仓库提交；大日志、照片原件继续归档到 T9。

## 从识别结果调用

同一服务提供 `POST /api`，需要 `Content-Type: application/json` 和 `X-Head: 1`。七类标签使用上述英文名，同时兼容旧名称 `surprised` → `surprise`。

```bash
curl -sS http://127.0.0.1:8770/api \
  -H 'Content-Type: application/json' -H 'X-Head: 1' \
  -d '{"op":"emotion","label":"happy","intensity":0.6,"transition":1.0,"hold":2.0}'
```

这条命令会实际通电并执行已保存的 happy，达到目标后保持 2 秒，再以同样过渡回到已标定 neutral。省略 `hold` 或设为 `null` 则保持目标姿态；它不是卸力命令。强度和识别置信度是不同参数，应由上层回应策略决定。

| 参数 / 操作 | 约定 |
|---|---|
| `intensity` | 0–1，默认 1；0 为 neutral |
| `transition` | 0.2–10 秒，默认 1；每 50 ms 指令步长不超过 5°，串口耗时可能使实际过渡更长 |
| `hold` | 0–30 秒或 null；数值表示保持后回 neutral，null 表示保持当前表情 |
| `revision` | 可选；页面重放携带预览版本，过期时拒绝执行 |
| `{"op":"load_expression","label":"happy","intensity":0.6}` | 只预览，结果在 `state.preview` |
| `{"op":"relax"}` | 中断动作并全部卸力 |
| `GET /state` | `busy`、`error`、板子在线情况、表情库状态与控制角度 |
| `GET /expressions.json` | 完整导出 JSON |

成功请求返回 200 与 `state`，动作异步执行；调用方需继续查看 `busy` 和 `error`。未标定、过期配置、动作忙、板子离线、非法参数返回 400 与 `error`，不会退回旧版预设。动作忙时不排队，不打断当前标定；连续识别结果应由上层合并并在空闲时提交最新有效结果。重放时若还有 neutral 集合之外的已知通电通道，会要求先卸力。

目前接通的是“手动标定 → 持久化 → 重放 → 标签 API”。SenseVoice、EmotiEffNet、LoRA 与慢层的实时接入，以及旧 hub / HeadBridge 的迁移，仍按下一阶段方案推进。

## 验证

```bash
.venv/bin/python -m pytest tests/test_pose_library.py tests/test_tune_server.py tests/test_calibration_session.py -q
```

覆盖重启恢复、加载不触发串口、原始角度不重复补偿、强度插值、保持后回中、卸力中断、离线拒绝、通道一致性、配置失效、写失败保留旧文件，以及 HTTP 保存—重启—标签调用。所有自动动作测试使用内存串口，不替代真机机械验收。
