letteryzzm/emotionbot/docs/资料导航.md

# EmotionBot 资料导航

> 整理于 2026-11-09。日期较早的计划和交接保留历史语境；当前状态应与实际代码和最近的实测记录交叉核对。

| 要做什么 | 先读 | 图解 / 补充 |
|---|---|---|
| 看项目和演示 | [项目 README](../README.md) | [版本与素材](项目版本与素材.md) |
| 下一阶段开发 | [上位机情绪识别与表情标定](下一阶段方案-上位机情绪识别与标定.md) | 不使用 T5；模型选型、快慢层规则与实施顺序 |
| 复现硬件 | [复现计划](复现计划.md)、[螺丝与热熔螺母](螺丝与热熔螺母清单.md) | [组装流程](组装流程.html)、[组装一览](组装一览图.html) |
| 焊接和供电 | [电源与接线](电源与接线.md) | [焊接流程](焊接流程.html)、[电源线焊接](电源线焊接流程.html) |
| 排查机构 | [装配核查](装配核查-可选与待测.md)、[颈部支架](../scripts/neck_stand/README.md) | [眼部传动](眼部传动与组装.html) |
| 上电和标定 | [下巴和嘴部交接](下巴和嘴部测试交接.md)、[标定交接](舵机标定与表情交接-2026-11-07.md) | [上电检查](舵机接线与上电检查.html)、[眉毛板接线](眉毛板杜邦线接线图.html)、[标定图](舵机标定图.html)、[调试日志](表情调试日志.html) |
| 理解控制 | [统一控制进程](统一控制进程.md)、[视觉模块](视觉模块-眼球跟随与距离表情.md) | [固件协议测试](固件协议测试记录-2026-11-06.md) |
| 运行灵眸 | [灵眸戏台](灵眸戏台.md) | [3D 网页渲染调研](3D机器头网页渲染-调研与方案.md) |
| 查历史 T5 实现（后续不使用） | [EB2 协议](T5屏幕与语音协议-EB2.md)、[表情同步交接](T5表情同步交接-给联合调试session.md) | [固件说明](../firmware_t5/README.md) |
| 读实验 | [情感识别模块](情感识别模块/README.md)、[实验报告](情感识别模块/06-实验报告.md) | [测评代码](../emo_bench/README.md)、[同子集对比](../emo_bench/results/same_subset.md)、[快层评测](../emo_bench/results/fast_layer.md) |

HTML 图解包含内嵌图片，下载后可直接用浏览器打开。完整研究综述在 `综述/`；个人学习批注与笔记版本以 note 仓库为主。
