letteryzzm/emotionbot/docs/情感识别模块/01-学习资源.md

# 01 学习资源

> 阅读顺序：先社区笔记 / 教程建立整体图景 → 每个模态读 1 篇综述 → 关键论文 → 跑开源实现。
> GitHub 仓库的 star、许可证、最近更新时间用 GitHub API 查过（2026-10-18）。论文里的数字都是作者自己报告的。

---

## 1. 社区笔记、课程和教程（先看这些）

| 资源 | 类型 | 覆盖 | 为什么看 | 链接 |
| --- | --- | --- | --- | --- |
| CMU 11-777 Multimodal Machine Learning（Morency） | 课程（公开视频 + slides） | 多模态表示、对齐、融合 | 融合方法的系统框架；情感识别是这门课的经典应用 | [课程主页](https://cmu-multicomp-lab.github.io/mmml-course/fall2020/) |
| Aman.ai Multimodal ML 笔记 | 社区笔记 | 11-777 的文字版整理 | 不想看视频时的替代 | [aman.ai/multimodal](https://aman.ai/multimodal/) |
| ACL 2017 Tutorial: Multimodal Machine Learning  | Tutorial | 语言 + 视觉 + 语音融合 | 比课程更短，2 小时能过完 | [ACL Anthology P17-5002](https://aclanthology.org/P17-5002/) |
| audeering/w2v2-how-to | 教程（notebook） | 用 wav2vec2 做维度情感（A/D/V） | **SER 入门最好的实操教程**，一步步讲特征提取、回归头、评测 | [github](https://github.com/audeering/w2v2-how-to)（★564） |
| emotion2vec 在 ModelScope / FunASR 的用法 | 中文教程 | emotion2vec 加载、utterance / frame 级特征、9 类模型 | 中文、直接可跑 | [阿里云开发者社区](https://developer.aliyun.com/article/1454260) · [proginn 模型页](https://www.proginn.com/w/1546030) |
| SpeechBrain 的 IEMOCAP emotion recipe | 教程 / 代码 | wav2vec2 / ECAPA 做 SER 的完整训练流程 | 学"标准训练脚本长什么样" | [speechbrain](https://github.com/speechbrain/speechbrain)（`recipes/IEMOCAP/emotion_recognition`） |
| hsemotion-onnx / EmotiEffLib 示例 | 教程（notebook） | 人脸检测 → 裁剪 → 表情 + V/A | FER 实时推理的最小可用流程 | [EmotiEffLib](https://github.com/sb-ai-lab/EmotiEffLib) · [hsemotion-onnx](https://github.com/av-savchenko/hsemotion-onnx) |
| declare-lab/conv-emotion | 代码合集 | DialogueRNN、DialogueGCN、COSMIC 等 ERC 经典模型  | **TER（对话情绪）的前 LLM 时代全景**，一个仓库全有 | [github](https://github.com/declare-lab/conv-emotion)（★1.5k，MIT） |
| MER-Factory | 工具 | 情感数据预处理、用 MLLM 自动标注、评测 | 看社区怎么搭"情感数据流水线" | [github](https://github.com/Lum1104/MER-Factory)（MIT） |

### Awesome 列表（查漏补缺用，不用通读）

| 列表 | 方向 | 备注 |
|---|---|---|
| [abikaki/awesome-speech-emotion-recognition](https://github.com/abikaki/awesome-speech-emotion-recognition) | SER | 117 条，分综述 / 数据集 / 工具 / 论文 |
| [SuperKogito/SER-datasets](https://github.com/SuperKogito/SER-datasets) | SER 数据集 | 最全的 SER 数据集表，含语言、规模、许可 |
| [EvelynFan/AWESOME-FER](https://github.com/EvelynFan/AWESOME-FER) | FER | 按会议年份列论文，**2022 年后没更新** |
| [pliang279/awesome-multimodal-ml](https://github.com/pliang279/awesome-multimodal-ml) | 多模态 | 11-777 助教维护，★6.9k |

---

## 2. 综述（每个模态读一篇）

| 模态 | 综述 | 读法 |
|---|---|---|
| FER | Li & Deng, **Deep Facial Expression Recognition: A Survey**, IEEE TAC 2020（[arXiv 1804.08348](https://arxiv.org/abs/1804.08348)） | 重点看数据集表、静态 vs 动态、身份 / 姿态 / 光照这些干扰因素；模型部分已过时，跳读 |
| SER | Akçay & Oğuz, **Speech emotion recognition: Emotional models, databases, features, preprocessing methods, supporting modalities, and classifiers**, Speech Communication 2020 | 读情感模型（离散 vs 维度）和声学特征部分，是理解 MFCC / eGeMAPS 基线的基础 |
| SER（新） | Wagner et al., **Dawn of the Transformer Era in Speech Emotion Recognition: Closing the Valence Gap**, IEEE TPAMI 2023（[arXiv 2203.07378](https://arxiv.org/abs/2203.07378)） | audeering 那个维度模型的论文，讲清楚了"自监督模型为什么在 valence 上突然变好"——因为隐含学到了语言信息 |
| TER / ERC | Poria et al., **Emotion Recognition in Conversation: Research Challenges, Datasets, and Recent Advances**, IEEE Access 2019（[arXiv 1905.02947](https://arxiv.org/abs/1905.02947)） | 讲清楚了对话情绪和单句情绪的区别：上下文、说话人状态、情绪转移 |
| 多模态 | Baltrušaitis, Ahuja, Morency, **Multimodal Machine Learning: A Survey and Taxonomy**, TPAMI 2018（[arXiv 1705.09406](https://arxiv.org/abs/1705.09406)） | 融合部分（early / late / hybrid）是我们融合层设计的依据 |

---

## 3. 关键论文（按模态）

### 3.1 FER

| 论文 | 发表 | 为什么重要 | 代码 |
|---|---|---|---|
| **HSEmotion / EmotiEffNet** 系列 | ABAW 2022–2026 | 轻量 EfficientNet，多任务（8 类 + V/A），速度快，**是我们 FER 主力**。AffectNet-8 准确率 61.93%、7 类 64.94%；V/A 的 CCC 分别 0.594 / 0.549（AffectNet val） | [EmotiEffLib](https://github.com/sb-ai-lab/EmotiEffLib)（Apache-2.0）· [ABAW-10 论文](https://arxiv.org/abs/2603.12693) |
| POSTER / POSTER++ | ICCV 2023 workshop / PR | 静态 FER 刷榜代表，RAF-DB 92% 左右 | [POSTER](https://github.com/zczcwh/POSTER) |
| **OpenFace 3.0** | 2025 | 一个模型出 landmark + AU + gaze + 情绪；AU 是可解释特征 | [github](https://github.com/CMU-MultiComp-Lab/OpenFace-3.0)（**仅限非商业学术**）· [arXiv 2506.02891](https://arxiv.org/abs/2506.02891) |
| **DFEW** | ACM MM 2020 | 动态 FER 的标准数据集：16,372 个电影片段，7 类，5 折，报 UAR / WAR | [arXiv 2008.05924](https://arxiv.org/abs/2008.05924) · [官网](https://dfew-dataset.github.io/) |
| **MAE-DFER** | ACM MM 2023 | 视频自监督预训练做动态 FER，DFEW 上比监督基线 UAR 高 6.3 个点 | [github](https://github.com/sunlicai/MAE-DFER)（MIT） |
| **DFER-CLIP** | BMVC 2023 | 用 CLIP + 文本描述做动态 FER，代表"视觉语言模型"路线 | [github](https://github.com/zengqunzhao/DFER-CLIP)（MIT）· [arXiv 2308.13382](https://arxiv.org/abs/2308.13382) |
| S4D（Static for Dynamic） | 2024 | 用静态表情数据帮动态识别 | [arXiv 2409.06154](https://arxiv.org/abs/2409.06154) |
| FER vs VLM 对比 | Frontiers in AI 2026 | 专用小模型泛化超过 VLM —— 支持"实时用专用模型" | [链接](https://www.frontiersin.org/journals/artificial-intelligence/articles/10.3389/frai.2026.1800342/full) |

### 3.2 SER

| 论文 | 发表 | 为什么重要 | 代码 |
|---|---|---|---|
| **emotion2vec** | ACL 2024 Findings | 情感专用自监督表示；只训线性层就超过通用模型；emotion2vec+ 用约 15 万小时中英伪标签数据迭代微调 | [github](https://github.com/ddlBoJack/emotion2vec)（MIT）· [arXiv 2312.15185](https://arxiv.org/abs/2312.15185) |
| **EmoBox** | Interspeech 2024 | 32 个数据集、14 种语言的统一划分；**我们的 SER 复现协议就用它** | [github](https://github.com/emo-box/EmoBox) · [arXiv 2406.07162](https://arxiv.org/abs/2406.07162) |
| **SenseVoice**（FunAudioLLM 技术报告） | 2024 | ASR + 情感 + 事件一体；非自回归，延迟极低；开源的是 Small，**README 里最强的 SER 结果大多属于未开源的 Large** | [github](https://github.com/QwenAudio/SenseVoice)（MIT） |
| Dawn of the Transformer Era in SER | TPAMI 2023 | 维度情感（A/D/V）的公开强基线 | [w2v2-how-to](https://github.com/audeering/w2v2-how-to)（模型 **CC BY-NC-SA 4.0**） |
| Interspeech 2025 自然场景 SER 挑战赛总结 | Interspeech 2025 | 70% 队伍用 WavLM、47% 用 Whisper；**语音 + 文本融合**是最一致的规律 | [论文](https://www.isca-archive.org/interspeech_2025/naini25_interspeech.html) |

### 3.3 TER（对话情绪识别 ERC 为主）

| 论文 | 发表 | 为什么重要 | 代码 / 数据 |
|---|---|---|---|
| **M3ED** | ACL 2022 | **首个中文多模态对话情绪数据集**：56 部电视剧、990 段对话、24,449 句，7 类，音视文三模态 | [github](https://github.com/AIM3-RUC/RUCM3ED) · [arXiv 2205.10237](https://arxiv.org/abs/2205.10237)（数据需向作者申请） |
| CPED | 2022 | 中文个性化情感对话数据集，ERC 榜上 BERT 类基线准确率约 51.5% | [HyperAI 榜单](https://www.hyper.ai/cn/sota/tasks/emotion-recognition-in-conversation/benchmark/emotion-recognition-in-conversation-on-cped) |
| SMP2020-EWECT | SMP 2020 评测 | 微博单句情绪 6 类（积极、愤怒、悲伤、恐惧、惊奇、无情绪）；用来练"单句分类"基线 | 评测官网申请 |
| MELD | ACL 2019 | 英文 ERC 标准集（老友记），三模态 | [arXiv 1810.02508](https://arxiv.org/abs/1810.02508) |
| GoEmotions | ACL 2020 | 英文 27 类细粒度情绪，规模大 | [arXiv 2005.00547](https://arxiv.org/abs/2005.00547) |
| **InstructERC** | 2023 | 把 ERC 改成 LLM 生成式任务 + 检索相似示例；后面一批 LLM-ERC 的起点 | [github](https://github.com/LIN-SHANG/InstructERC) |
| CoE（Clue of Emotion） | ACL 2025 | 加角色扮演、说话人识别、情绪推理辅助任务，在 MELD / IEMOCAP / EmoryNLP 上报告 SOTA | [ACL 2025](https://preview.aclanthology.org/landing_page/2025.acl-long.1148.pdf) |
| Curriculum LoRA for ERC | AAAI 2026 | 按"情绪转移难度"排序做 LoRA 课程学习 | [arXiv 2511.07061](https://arxiv.org/abs/2511.07061) |
| THOR | ACL 2023 | 用 CoT 推理隐式情感（字面没有情绪词） | [github](https://github.com/scofield7419/THOR-ISA)（Apache-2.0） |

### 3.4 多模态融合 / 中文多模态

| 资源 | 为什么重要 | 链接 |
|---|---|---|
| **MER 2023–2026 挑战赛 + MERTools** | 数据来自中文影视，**和机器人的中文用户场景最接近**；官方 baseline 提取声学 / 文本 / 视觉特征再融合，代码全开源 | [MERTools](https://github.com/zeroQiaoba/MERTools) · [MER2024 论文](https://arxiv.org/abs/2404.17113) · [MER2025](https://arxiv.org/abs/2504.19423) · [HF 数据集（需签 EULA）](https://huggingface.co/datasets/MERChallenge/MER2023) |
| **CH-SIMS v2** + MMSA | 中文多模态情感分析（极性，不是 7 类），MMSA 框架集成了十几个融合模型 | [ch-sims-v2](https://github.com/thuiar/ch-sims-v2)（网盘直接下载）· [MMSA](https://github.com/thuiar/MMSA)（MIT） |
| Emotion-LLaMA / AffectGPT | MLLM 路线的代表，作为"上限对照" | [Emotion-LLaMA](https://github.com/ZebangCheng/Emotion-LLaMA) · [AffectGPT](https://github.com/zeroQiaoba/AffectGPT) |
| Qwen2.5-Omni / Qwen3-Omni | 端到端音视频输入，作为"不做专门融合"的对照 | [Qwen3-Omni 报告](https://arxiv.org/abs/2509.17765) |

---

## 4. 数据集获取难度一览（决定排期）

| 数据集 | 模态 | 语言 | 获取方式 | 预计等待 |
|---|---|---|---|---|
| RAVDESS、CREMA-D | 音频（+ 视频） | 英 | 直接下载 | 0 |
| ESD | 音频 | 中 / 英 | GitHub 填表 | 几天 |
| CH-SIMS v2 | 三模态 | 中 | 网盘直接下载 | 0 |
| M3ED | 三模态 | 中 | 向作者申请 | 1–2 周 |
| MER2023–2025 | 三模态 | 中 | HF 签 EULA | 几天 |
| RAF-DB | 图像 | — | 邮件申请 | 1–2 周 |
| AffectNet | 图像 | — | 学术申请 | 1–4 周 |
| DFEW | 视频 | — | 签协议 | 1–2 周 |
| IEMOCAP | 三模态 | 英 | USC 申请 | 1–4 周，可选 |

**行动项：第一天就把 M3ED、RAF-DB、AffectNet、DFEW、MER 的申请全发出去**，等待期间先用 RAVDESS / CREMA-D / CH-SIMS v2 跑通流程。

---

## 5. 建议阅读和动手顺序（约 3 周）

| 天 | 内容 |
|---|---|
| 1–2 | 11-777 融合相关两讲 + Poria ERC 综述；发数据申请 |
| 3–5 | SER：w2v2-how-to 教程 → emotion2vec 论文 → 跑 SenseVoice / emotion2vec+ 在 RAVDESS 上 |
| 6–8 | FER：Li & Deng 综述 → EmotiEffLib 示例 → MediaPipe 检测 + EmotiEffNet 实时跑起来 |
| 9–11 | TER：conv-emotion 里跑一个 DialogueRNN → InstructERC 论文 → 在 CH-SIMS / M3ED 文本上试 RoBERTa 和 LLM zero-shot |
| 12–14 | 融合：MERTools baseline 读代码 → 自己写 late fusion |
| 15+ | 动态 FER（MAE-DFER / DFER-CLIP）和 LLM LoRA 上云 |
