letteryzzm/emotionbot/culture/samples/anime2_131511080.jpg

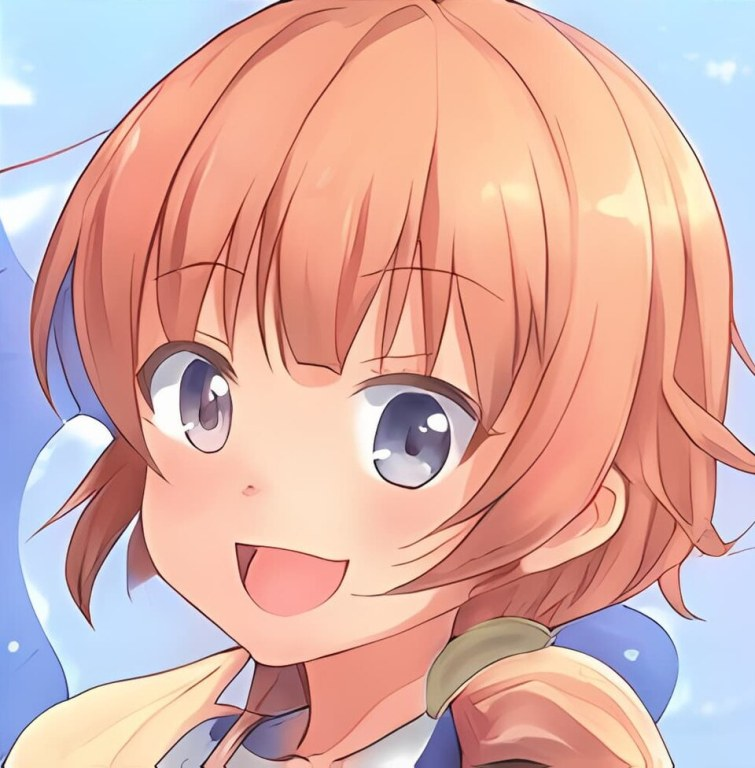
culture/samples/anime2_131511080.jpg
