letteryzzm/emotionbot/culture/samples/anime2_131511181.jpg

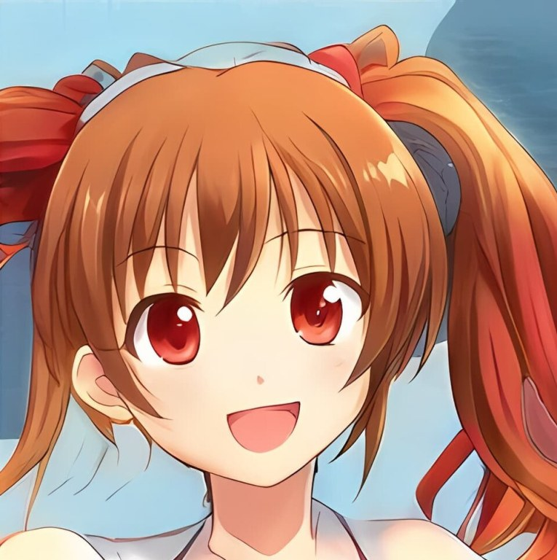
culture/samples/anime2_131511181.jpg
