letteryzzm/emotionbot/culture/samples/anime3_148975333.jpg

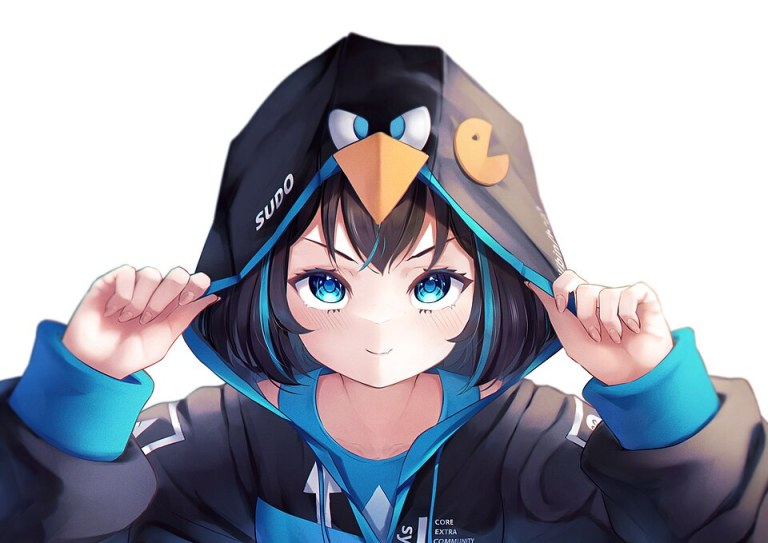
culture/samples/anime3_148975333.jpg
