letteryzzm/emotionbot/culture/samples/op4_7526800.jpg

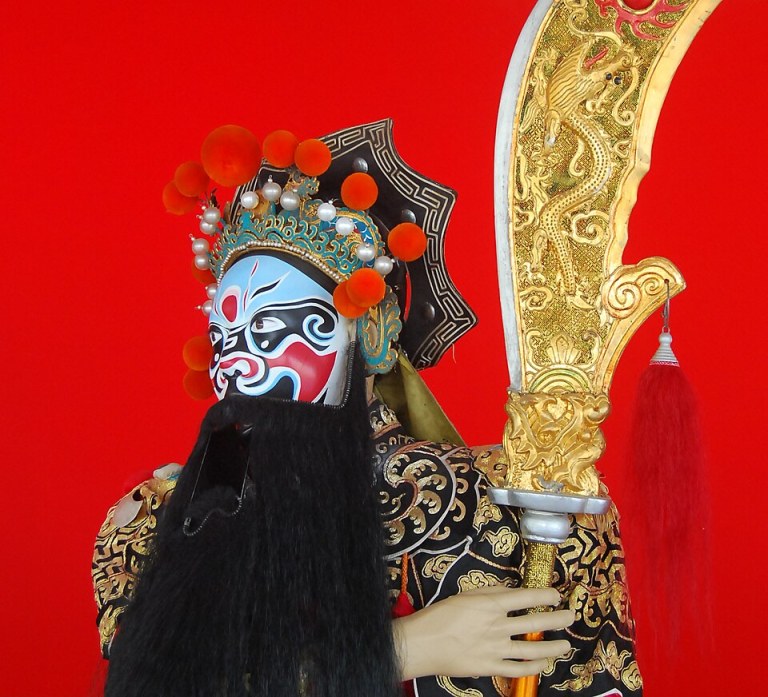
culture/samples/op4_7526800.jpg
