letteryzzm/emotionbot/culture/samples/op4_7585138.jpg

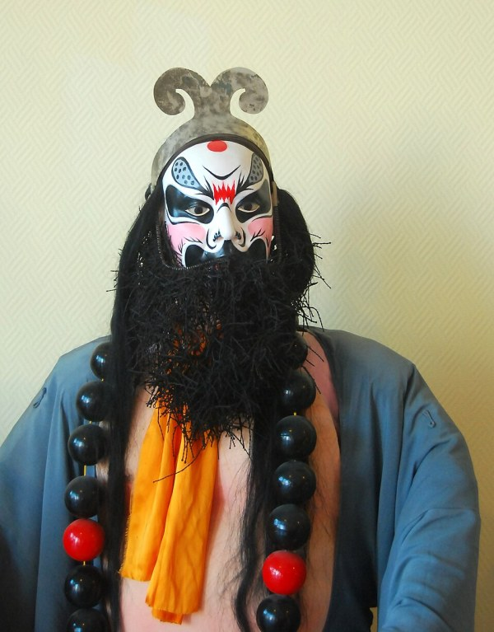
culture/samples/op4_7585138.jpg
