letteryzzm/emotionbot/culture/samples/op5_94619944.jpg

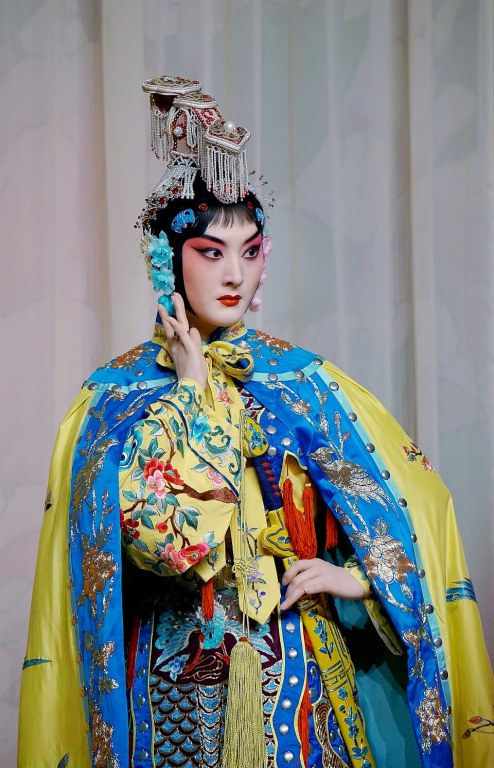
culture/samples/op5_94619944.jpg
