letteryzzm/emotionbot/culture/samples/op6_90045896.jpg

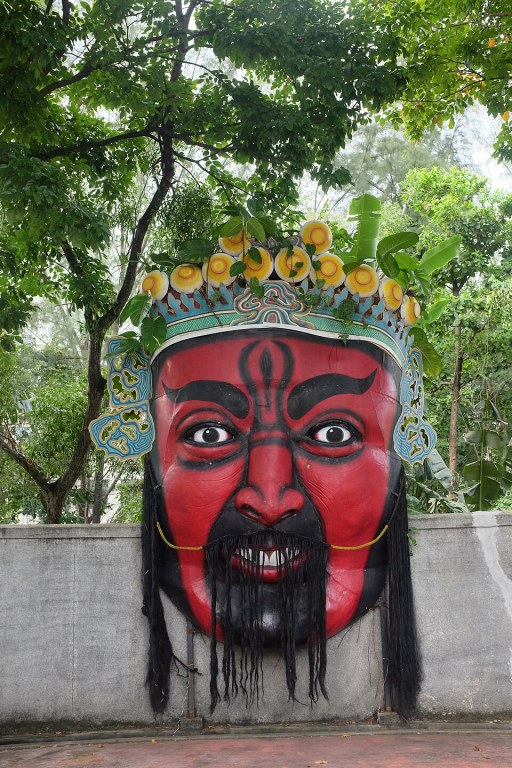
culture/samples/op6_90045896.jpg
