letteryzzm/emotionbot/culture/samples/opera3_7526534.jpg

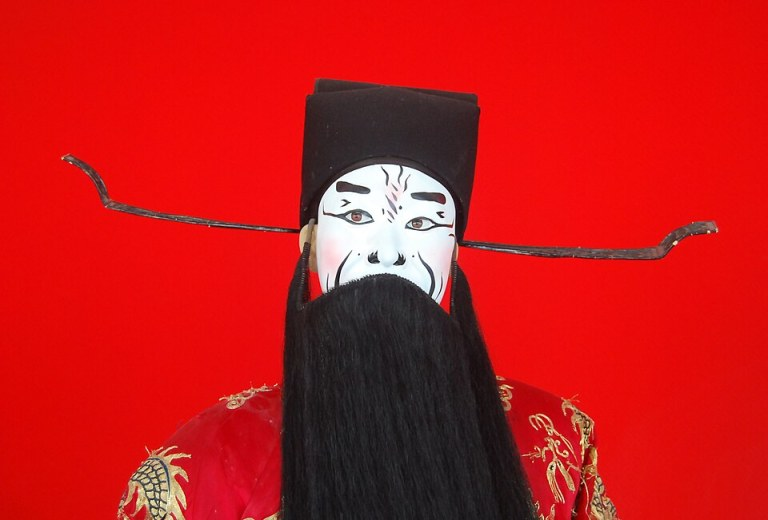
culture/samples/opera3_7526534.jpg
