letteryzzm/emotionbot/docs/media/真机.jpg

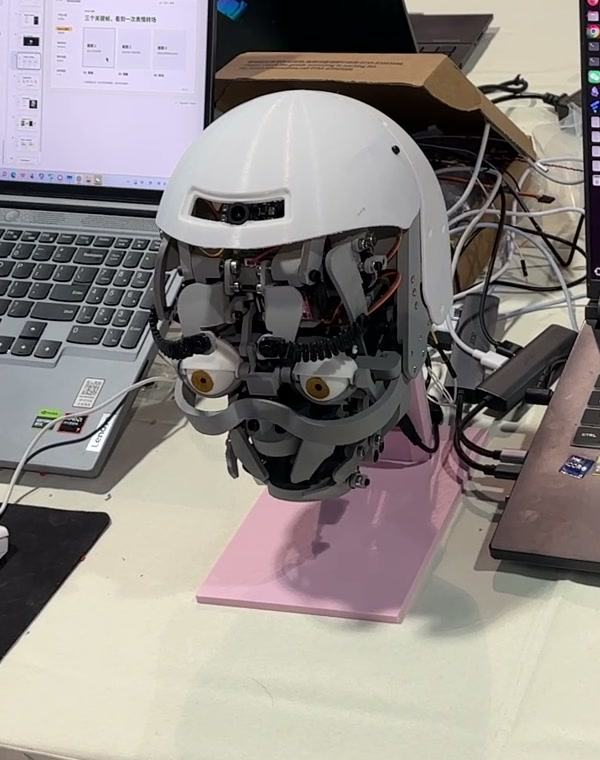
docs/media/真机.jpg
