letteryzzm/emotionbot/docs/螺丝与热熔螺母清单.md

# 螺丝与热熔螺母清单

> 2026-10-31。数据来源：从参考装配模型（Onshape 导出的 OBJ）里，逐颗螺丝量出它穿过的零件和孔径、孔深。
> 测量脚本：`scripts/hole_measure/`。
> 装配模型**画得不全**：右侧 2 个眉毛舵机（连杆都画了）、外壳和牙齿的固定、眉毛的螺丝、电路板和风扇的固定都没画。所以下面"模型数量"是下限，购买量按套装或加余量。

## 1. 热熔螺母怎么选

> 2026-11-04 复核（按网格里的圆孔逐个数）：M2 16、M3 22、M4 16。另有 3 个孔模型里没画螺丝：眼部底板 y=8 处 2 个 M3 孔，下颌座 1 个 M4 孔（大概率是舌头连杆 Part_19 的转轴）。
> **模型没画、之前漏算的（2026-11-04）**：眉毛底板 Part_4 要 M4 ×12（8 个接框架，4 个推测是台阶螺丝转轴）、M2 ×8（4 个眉毛舵机）。可选：风扇 M3 ×10（框架 6、FanBracket 4）、外壳 M3 ×14（RearPlate 10、FrontVent 4）。全部压完 M3 约 48 颗，50 颗只剩 2 颗余量；M4 必压 28 颗，30 颗剩 2 颗。

**规则：看打印件上的孔径。热熔螺母外径 = 孔径 + 0.2 到 0.5 mm；长度不能超过孔深。**

模型里所有拧螺丝的孔只有三种直径，正好对应 M2、M3、M4 三种热熔螺母：

| 规格 | 模型孔径 | 最浅孔深 | 在哪些零件上 | 模型里数量 | 买什么 | 建议买 |
|---|---|---|---|---|---|---|
| **M2** | Ø3.2 | 约 7.6 mm | TopBase、JawBase（固定嘴部的 MG90S） | 16 | 外径 3.5、长 3 到 4 mm | 50 个一包 |
| **M3** | Ø4.3 到 4.4 | 5 mm（CheekBone） | TopBase、CheekBone、SkullFrame 侧面、眼部 SnapEyemech | 22 | 外径 4.8 到 5.0、长 4 到 5 mm | 50 个一包 |
| **M4** | Ø5.35 | 6 mm（TopBase） | TopBase、JawBase（下颌、颧骨、台阶螺丝的转轴） | 16 | 外径 5.6 到 6.0、长 5 到 6 mm | 20 到 30 个 |

- 淘宝搜"**热熔铜螺母 滚花 M3**"之类。规格常写成 `M3*5*5.0`，三个数依次是 **螺纹、长度、外径**。不同店写法不一样，下单前看清楚哪一个是外径。
- 打印件到手后**先用卡尺量几个孔**。打印出来的孔通常比模型小 0.1 到 0.2 mm，量出来的孔径加 0.2 到 0.5 就是要买的外径。
- M3 不要买长度超过 5 mm 的，颧骨（CheekBone）上的孔只有 5 mm 深。
- M4 不要买超过 6 mm 长的，TopBase 上的孔只有 6 mm 深。模型里自带的 M4 热熔螺母画的是 9 mm 长，那是给 JawBase 用的（那里孔深 9 mm）。用 6 mm 的两边都能装。
- 眉毛和眼部的螺丝模型里没画，这几个模块大概率也用 M2、M3 热熔螺母，所以每种都多买，一包 50 个比较稳妥。

## 2. 螺丝清单

| 规格 | 模型里数量 | 建议买 | 用在哪（从模型里量出来的） |
|---|---|---|---|
| M2×6 内六角 | 22 | 40 | 14 颗：嘴部 MG90S 的安装耳 → TopBase / JawBase 里的 M2 热熔螺母；8 颗：下颌连杆 → **MG996R 舵盘**（直接拧进舵盘孔） |
| M2×8 内六角 | 2 | 10 | 两个叠在一起的 MG90S 安装耳 → TopBase |
| **M2.5×8** 内六角 | 8 | 16 | 穿过嘴部连杆，**拧进 MG90S 的输出轴**（当舵盘螺丝用），见下面说明 |
| M3×6 内六角 | 6 | 15 | 某个外购件（模型里叫 Component2）→ TopBase |
| M3×8 内六角 | 8 | 20 | 4 颗：SkullFrame → 颧骨；4 颗：SkullFrame → 眼部机构 |
| M3×10 内六角 | 6 | 15 | 模型画在头骨框架两侧，但外壳上没有孔，不用装。这批改用来固定 PCB（8 颗，配 5 mm 垫柱） |
| M4×6 内六角 | 2 | 6 | 颧骨 → TopBase |
| M4×8 内六角 | 4 | 10 | 下颌连杆 → JawBase |
| M4×16 内六角 | 6 | 12 | SkullFrame → TopBase（整个嘴部模块挂在头骨上） |
| **M3 台阶螺丝** 螺纹 4 mm、轴肩 Ø4×4 mm、头 Ø6 | 14 | 30 | 嘴唇和嘴角连杆的转轴 |
| **M4 台阶螺丝** 螺纹 4.5 mm、轴肩 Ø5×5 mm、头 Ø8 | 4 | 12 | 上唇、下唇的主转轴（2 颗在上颌座、2 颗在下颌座），拧进 M4 热熔螺母 |
| **M3 普通六角螺母**（不是尼龙防松螺母） | 14 | 30 | 嘴唇零件上有六角螺母槽，M3 台阶螺丝拧进这里 |
| M4 平垫、M5 平垫 | 各 1 | 各 10 | 套在台阶螺丝的**轴肩**上当垫片：M4 平垫（内孔 4.3）配 M3 台阶螺丝的 Ø4 轴肩，M5 平垫（内孔 5.3）配 M4 台阶螺丝的 Ø5 轴肩。垫在转动连杆和固定零件之间，减小摩擦、补间隙 |

### 两个和之前计划不一样的地方

1. **M2.5 不是用来固定 MG996R 的**（复现计划 4.1 写的是猜测）。实际上它穿过连杆，拧进 MG90S 的输出轴，作用相当于舵盘中心螺丝。所以官方说"Possibly M2.5 depending on servo"。
   - **2026-11-01 已确认：手上的 MG90S 输出轴是 M2.5**，按 M2.5×8 买。
   - 原先的判断方法：拿舵机包装袋里自带的那颗舵盘中心螺丝，用卡尺量螺纹外径。约 2.5 mm 就买 M2.5×8；约 2 mm 就把这 8 颗换成 M2×8。
2. **嘴唇的 M3 台阶螺丝配普通 M3 螺母**。螺母槽深约 2.6 mm，普通 M3 螺母厚 2.4 mm 刚好放得进去；尼龙防松螺母厚约 4 mm，放不进去。之前计划里写的"M3、M4 尼龙防松螺母"是给"用普通螺丝代替台阶螺丝"这种方案准备的，用台阶螺丝的话不需要。

### 2026-11-05 总装核对：模型没画的连接

孔位按同轴关系实测，长度按孔深算，见组装流程阶段 E、F。

| 连接 | 紧固件 | 数量 | 说明 |
|---|---|---|---|
| Part_4 → 头骨框架 | **M4×12** | 8 | M4×8 只进螺母 1 mm，M4×16 顶到孔底 |
| 眼部底板 → 头骨框架 | M3×8 | 6 | 模型画了 4 颗，还有 2 颗在 y=8 |
| FanBracket → 头骨框架 | M3×8 | 6 | |
| 风扇 → FanBracket | **M3×14** | 4 | 或用风扇自带自攻螺丝 |
| RearPlate → 头骨框架 | M3×6 | 11 | |
| FrontVent → 头骨框架 | M3×6 | 4 | |
| 三块 PCB → 头骨框架 | M3×10 + 5 mm 垫柱 | 8 | 垫柱高度是估计值 |
| 舌头连杆 | M4 台阶 1、M3 台阶 2、M3 螺母 2、M2.5×8 1 | | 模型没画 |
| 牙齿、牙龈、舌头、后格栅、额头条 | 胶 | | 没有螺丝孔 |

**M3 热熔螺母总量：** 模型 22 + 眼部后 2 + 风扇 10 + 外壳 15 = 49，加 PCB 8 = 57。框架两侧 6 个不用压，已从上面减掉后是 51。50 颗一包不够，再买一包，或者 PCB 改用尼龙柱。

### 模型里没画、要另外准备的

| 东西 | 说明 |
|---|---|
| 舵机自带的自攻螺丝 | 眼部 6 个舵机是卡进座子的，不用螺丝；眉毛舵机的固定方式模型里没画，**这些小包别扔** |
| 舵盘螺丝 | 舵机自带 |
| 风扇螺丝 | 风扇一般自带 4 颗 |
| 电路板固定 | 模型里没画。买 M2、M3 尼龙柱或者用扎带固定 |

**不用舵机自带螺丝时要加买的**（2026-11-01）：
- 眼部 6 + 眉毛 4 个 MG90S 的安装耳：20 颗 → M2×8 加 25，拧进 M2 热熔螺母
- 这 10 个 + 舌头 TON 的舵盘中心螺丝（打印舵盘比原装舵盘厚）：11 颗 → M2.5×8 加 15（输出轴是 M2 就换成 M2×8）
- 2 个 MG996R 安装耳：8 颗 → M3×12 + M3 螺母各 10（模型里没画，装之前量一下孔，孔 ≥4.3 也可以用 M4）
- MG996R 舵盘中心螺丝：M3×8，已经包含在前面的余量里

**最省事的买法**：买一盒 **M2 / M2.5 / M3 / M4 内六角螺丝套装**（每种都有 6、8、10、16 mm），再单独买台阶螺丝、M3 螺母和三种热熔螺母。

## 3. 清点表（打勾用）

| ☐ | 东西 | 需要 |
|---|---|---|
| ☐ | M2 热熔螺母（外径 3.5、长 3 到 4） | 约 30（模型 16 + 眉毛、眼部余量） |
| ☐ | M3 热熔螺母（外径 4.8 到 5.0、长 4 到 5） | 约 30（模型 22 + 余量，2026-11-04 复核） |
| ☐ | M4 热熔螺母（外径 5.6 到 6.0、长 5 到 6） | 约 20（模型 16 + 余量，2026-11-04 复核） |
| ☐ | M2×6 / M2×8 | 40 / 10 |
| ☐ | M2.5×8（或 M2×8，看舵机输出轴） | 16 |
| ☐ | M3×6 / M3×8 / M3×10 | 15 / 20 / 15 |
| ☐ | M4×6 / M4×8 / M4×16 | 6 / 10 / 12 |
| ☐ | M3 台阶螺丝 | 30 |
| ☐ | M4 台阶螺丝 SSHE-M4-5-5 | 12 |
| ☐ | M3 普通六角螺母 | 30 |
| ☐ | 平垫 M3 / M4 / M5 | **可不买**（2026-11-01 决定）。模型只在 2 处用：M4 平垫 ×1、M5 平垫 ×1。不装的话那两个关节多出 0.7 到 1 mm 的轴向间隙，晃得明显再补 |
| ☐ | 热熔螺母压头（烙铁头） | 1 |
| ☐ | 内六角扳手 1.5 / 2 / 2.5 / 3 mm | 1 套 |

## 4. 怎么量出来的（简单说明）

1. 装配模型里每颗螺丝都是一个独立零件，名字里带规格（例如 `Hex socket head cap screw M3x0.50 x 8`）。
2. 对每颗螺丝算出它的轴线，再找出轴线附近有哪些零件，量这些零件在轴线周围的孔径和孔的深度范围。
3. 螺丝头下面那个零件的孔是通孔（M3 是 Ø3.6，M4 是 Ø4.4 到 4.6），螺纹末端所在零件的孔是热熔螺母孔（Ø3.2 / 4.4 / 5.35）。如果末端是 Ø2.4 的孔，就是拧进舵机输出轴；如果是六角形的槽，就是放螺母的。

## 5. 采购状态（2026-11-01）

**已有**：M2×6 ×50（杯头）、M3×8 ×50（外六角，代替杯头 M3×8，头部没有沉孔，放得下）、24 格套装（M2.5/M2/M3/M4 各长度 ×10）、热熔螺母 M2×4×3.5 ×50 / M3×4×5 ×50 / M4×5×6 ×30、台阶螺丝 M3 Φ4×4 / M4 Φ5×5 各 1 包。

| 需要 | 模型数量 | 来源 |
|---|---|---|
| M2×6 | 22 | 50 袋装 ✓ |
| M2×8 | 2 | 套装 ✓ |
| M2.5×8 | 8 | 套装 10 ✓（余量少） |
| M3×6 | 8（就是 MG996R 的 8 颗） | 套装 10 ✓ |
| M3×8 | 8 | 外六角 50 袋装 ✓ |
| M3×10 | 6 | 套装 ✓ |
| M4×6 | 2 | **用 M4×8 代替**：螺丝尖后面还有 7.6 mm 空孔，不会顶底 |
| M4×8 | 4（加上代替 M4×6 的 2 颗共 6） | 套装 10 ✓ |
| M4×16 | 6 | 套装 ✓ |
| M3 台阶螺丝 | 14 | 已买，**数一下够不够 14** |
| M4 台阶螺丝 | 4 | 已买 ✓ |
| M3 普通六角螺母 | 14 | 以前项目剩的 ✓ |
| 平垫 | 2 | 不买 |

**眉毛另外要的（2026-11-05 核对，模型没画，按孔径和同轴关系推出来，见组装流程图 12）：**

| 规格 | 眉毛用量 | 全机合计 | 库存情况 |
|---|---|---|---|
| M3 台阶螺丝 | 8 | 22 | 数一下，不够要补 |
| M4 台阶螺丝 | 4（舌头再加 1） | 8 到 9 | 数一下，不够要补 |
| M3 普通六角螺母 | 12（台阶 8 + 软眉毛 4） | 26 | 现有 14，**不够** |
| M2.5×8 | 4 | 12 | 套装 10，**差 2** |
| M3×6 | 4（软眉毛，长度待试装） | 12 | 套装 10，**差 2**，也可试 M3×8 |

**还要买**：M3 台阶螺丝不够 14 就补一包；5.5 mm 六角套筒/螺母起子（拧外六角 M3×8）；可选 M2.5×8 一包备用。
