letteryzzm/emotionbot/pcb/立创商城_BOM配单.csv

商品编号 | 数量 | 型号 | 备注
C8678 | 3 | SS34 | 眼眉板二极管
C2903947 | 3 | SS1045 | 嘴部板二极管
C2887273 | 3 | 220uF 16V | 眼眉板电解电容
C72494 | 6 | 220uF 10V | 嘴部板电解电容
C3359 | 2 | 1000uF 16V | 嘴部板电解电容
C7173 | 3 | 100nF 钽电容 A型 | 眼眉板
C18212701 | 2 | AMS1117-5.0 | 嘴部板稳压
C428722 | 1 | XT60PW-F | 嘴部板电源座
C493111 | 2 | XH2.54 2P 弯插 | 眼眉板电源座
C7501274 | 6 | 2x3P 排针 | 嘴部板舵机接口
C32713276 | 6 | 2x3P 排针 | 眼眉板舵机接口
C2977589 | 2 | 2x20P 排母 | 嘴部板 Pico 插座
C136719 | 3 | 拨动开关 | 每块板 1 个
C157909 | 4 | 2P 排针 | 跳线用
