letteryzzm/emotionbot/pcb/立创商城BOM_3块板合计.csv

立创编号 | 型号 | 规格 | 封装 | 眼眉板每块 | 嘴部板 | 合计(2块眼眉板+1块嘴部板) | 建议购买 | 必需 | 位号 | 说明
C8678 | SS34 | 肖特基二极管 40V 3A | SMA | 1 | 0 | 2 | 3 | 是 | 眼眉板 D2 | 舵机电源二极管 注意极性
C2903947 | SS1045 | 肖特基二极管 45V 10A | SMB | 0 | 2 | 2 | 3 | 是 | 嘴部板 D1 D2 | 注意极性
C2887273 | RVT220UF16V67RV0015 | 电解电容 220uF 16V | SMD 6.3mm | 1 | 0 | 2 | 3 | 是 | 眼眉板 C10 | 注意极性
C72494 | RVT1A221M0605 | 电解电容 220uF 10V | SMD 6.3mm | 0 | 5 | 5 | 6 | 是 | 嘴部板 C2 C3 C5 C7 C8 | 注意极性
C3359 | RVT1C102M1010 | 电解电容 1000uF 16V | SMD 10mm | 0 | 1 | 1 | 2 | 是 | 嘴部板 C1 | 注意极性
C18212701 | AMS1117-5.0 | LDO 稳压 | SOT-223 | 0 | 1 | 1 | 2 | 是 | 嘴部板 U2 | 给 Pico 供电
C428722 | XT60PW-F | XT60 母座 卧式 | 插件 | 0 | 1 | 1 | 1 | 是 | 嘴部板 U1 | 5V 电源输入
C7501274 | ZX-PZ2.54-2-3PZZ | 2x3P 排针 2.54 | 插件 | 0 | 6 | 6 | 6 | 是 | 嘴部板 U3~U8 | 每个接 2 个舵机
C32713276 | HX PZ2.54-2x3P ZZ | 2x3P 排针 2.54 | 插件 | 3 | 0 | 6 | 6 | 是 | 眼眉板 J1~J3 | 每个接 2 个舵机
C2977589 | 2.54-2*20 | 2x20P 排母 2.54 | 插件 | 0 | 2 | 2 | 2 | 是 | 嘴部板 U9 U10 | Pico 插座
C493111 | S2B-XH-A | XH2.54 2P 弯插座 | 插件 | 1 | 0 | 2 | 2 | 是 | 眼眉板 U1 | 5V 电源输入
C136719 | SS-12D02-VG4 | 拨动开关 | 插件 | 1 | 1 | 3 | 3 | 是 | SW1 | 原版的模式/校准开关
C157909 | SB2P-HVQ-CA | 2P 排针 2.54 | 插件 | 1 | 2 | 4 | 4 | 是 | 嘴部板 H1 H3(BOARD POWER) / 眼眉板 H3 | 配跳线帽
C55509 | L78M05CDT-TR | 5V 稳压 | TO-252 | 1 | 0 | 2 | 2 | 否 | 眼眉板 U2 | 只在接 12V 输入时用；按本方案接 5V 可以不焊
C600509 | T491B334K050AT | 钽电容 330nF 50V | B 型 3528 | 1 | 0 | 2 | 2 | 否 | 眼眉板 C13 | L78M05 输入电容；不焊 U2 就不用 注意极性
C7173 | TAJA104K035RNJ | 钽电容 100nF 35V | A 型 3216 | 1 | 0 | 2 | 3 | 是 | 眼眉板 C14 | 5V 去耦 注意极性
C965807 | XL-1608UBC-04 | 蓝色 LED | 0603 | 2 | 1 | 5 | 6 | 否 | LED | 电源指示灯，可以不焊
C25346 | 1206W4F910JT5E | 电阻 91Ω | 1206 | 2 | 1 | 5 | 6 | 否 | R | LED 限流电阻，不焊 LED 就不用
C725952 | X6511WV-20H-C60D30 | 1x20P 排针 2.54 | 插件 | 2 | 0 | 4 | 0 | 否 | 眼眉板 H1 H2 | 建议改用下面的 1x20 排母，Pico 可以拔插
 | 1x20P 排母 2.54(淘宝) |  | 插件 | 2 | 0 | 4 | 4 | 是 | 眼眉板 H1 H2 | 代替原版的排针，配带排针的 Pico H
 | 0805 0Ω 电阻(或直接焊锡短接) |  | 0805 | 1 | 0 | 2 | 4 | 是 | 眼眉板 C12(5V Select) | 接 5V 电源时必须短接 C12，C11 不焊
 | 2.54 跳线帽 |  |  | 0 | 1 | 1 | 3 | 是 | 嘴部板 BOARD POWER | 插上后板子给 Pico 供电
C2845363 | HC-1.0-4PWT | SH1.0 4P 贴片座 | SMD | 2 | 2 | 6 | 0 | 否 | CN1 CN2 | 原版两板互联用；本方案每块 Pico 接 USB，不焊
