letteryzzm/emotionbot/print_package/给朋友打印_2026-11-01/TopLidHorn_眼皮舵盘_x3.stl

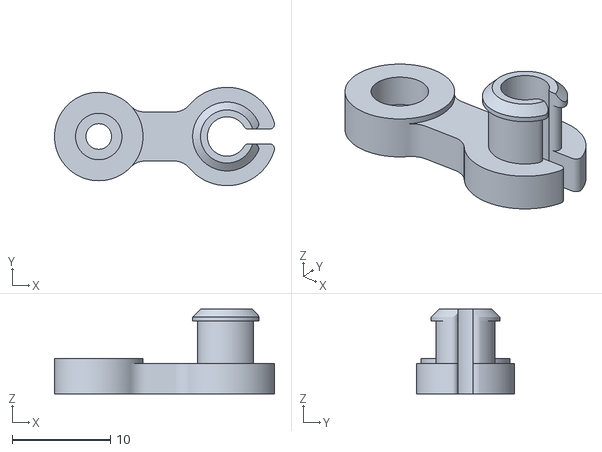
[picture p38: CAD file, 2026-11-05]
print_package/给朋友打印_2026-11-01/TopLidHorn_眼皮舵盘_x3.stl
22.4 x 10.00 x 8.60
