letteryzzm/emotionbot/print_package/给朋友打印_2026-11-01/ServoSizingPlate_舵机尺寸测试块_x1.stl

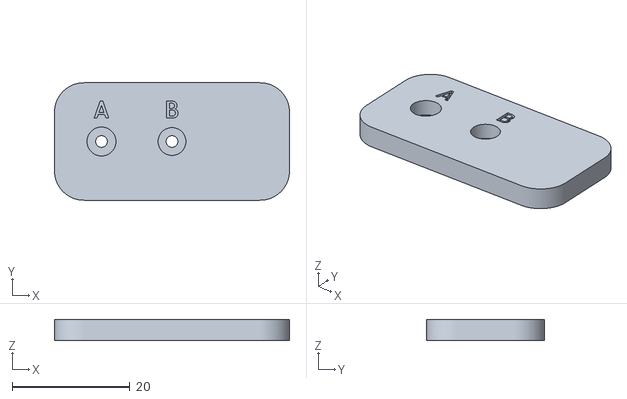
[picture p39: CAD file, 2026-11-05]
print_package/给朋友打印_2026-11-01/ServoSizingPlate_舵机尺寸测试块_x1.stl
40.0 x 20.0 x 3.60
