letteryzzm/emotionbot/print_package/给朋友打印_2026-11-01/NeckStand_颈部支架_x1.stl

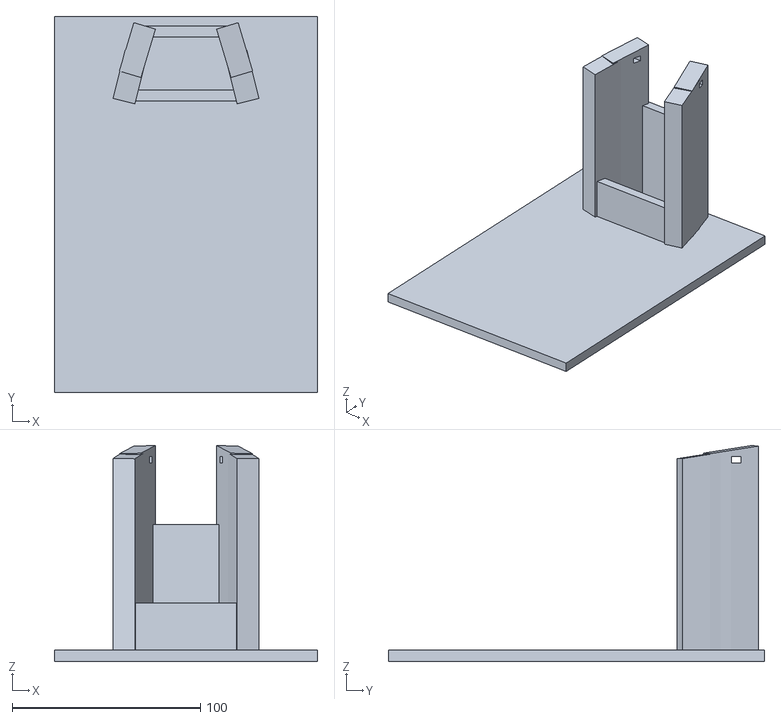
[picture p40: CAD file, 2026-11-05]
print_package/给朋友打印_2026-11-01/NeckStand_颈部支架_x1.stl
140.0 x 200.0 x 114.9
