letteryzzm/emotionbot/print_package/给朋友打印_2026-11-01/Eyeball_官方_x2.stl

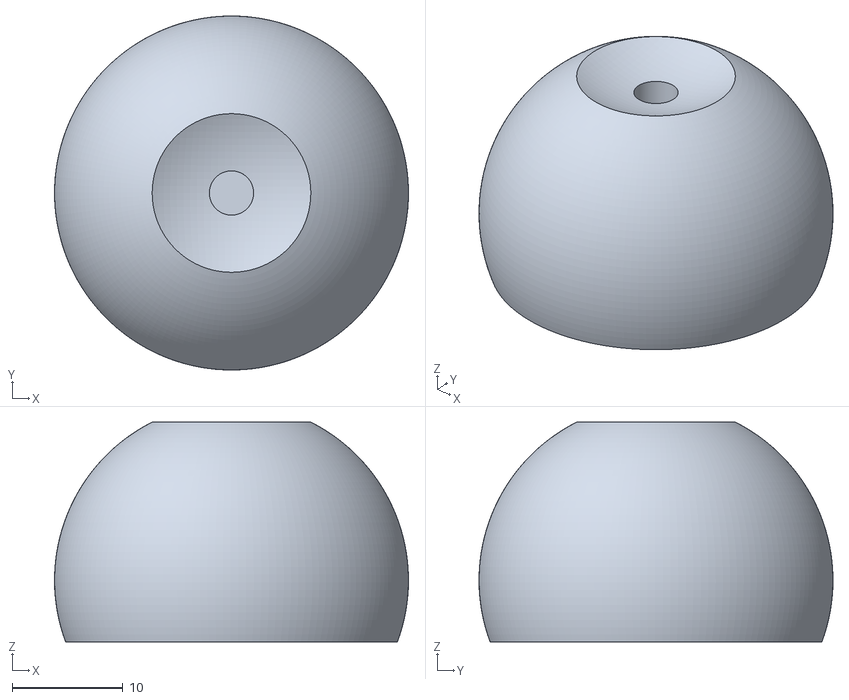
[picture p41: CAD file, 2026-11-05]
print_package/给朋友打印_2026-11-01/Eyeball_官方_x2.stl
32.0 x 32.0 x 19.9
