letteryzzm/emotionbot/docs/装配核查-可选与待测.md

# 装配核查：哪些可选、哪些要实装测试

> 2026-11-01。对照参考装配模型（191 个零件，Blender 里同一份）、打印包 `print_package/STL/`（plate1 到 plate9）、固件 `firmware/config_*.py` 逐项核对。
> 结论分三类：**A 可选**（不装也能动）、**B 模型和打印包对不上**（多打了或模型没画）、**C 必须实装测试才能确定**。

## A. 可选的零件 / 步骤（之前没说清楚）

| 零件 / 步骤 | 打印包位置 | 作用 | 不装的后果 |
|---|---|---|---|
| FrontPlate 额头装饰条 | plate9 | 纯装饰 | 无 |
| 外壳：RearPlate 后盖、FrontVent 前格栅、RearVent 后格栅 | plate1 | 外观、护线 | 机构照常动，调试阶段**先别装**，方便看和改线 |
| 牙齿、牙龈（MouthAssembly Part_1 系列 4 件） | plate8 | 外观 | 无；可以最后再装 |
| 舌头 TongueSculpt + 舌头舵机 TON | plate8 | 一个表情自由度 | 少一个舵机；做情感学习时可以先关掉 |
| 风扇 + FanBracket | plate6 | 散热 | 短时间调试可以不装；长时间跑 19 个舵机建议装 |
| M4 / M5 平垫 | — | 关节减摩、补间隙 | 已决定不装 |
| 眼球 | plate9 | — | 打印或买成品二选一 |
| 嘴部 EXA 备用口（GP15） | 固件 | 原版没用 | 不接 |

## B. 模型和打印包对不上的地方

| 项目 | 打印包 | 模型里 | 怎么办 |
|---|---|---|---|
| EyeAdaptor | EyeAdaptor ×2 + EyeAdaptor_v2 ×2 = 4 个 | 只用 2 个：1 个 EyeAdaptor、1 个 EyeAdaptor_v2 | 多出 2 个是备件或改版件。装的时候先按模型（左右各一种），哪个和眼球配合紧就用哪个 |
| EyeCorePivotHolder | 原版 ×1 + v2 ×1 | 只用 1 个（原版） | v2 是改版，先装原版，不合适再换 v2 |
| LidTR / LidTR_v2 | 各 1 | 各 1（下眼皮位置） | 左右各一，按模型位置 |
| **LateralFrame** | ×1 | **模型里没有** | 推测是固定眼球左右舵机（LR）的框，**要实装试** |
| 眉毛舵机 | 固件里 4 个（LO、LI、RI、RO） | **只画了机器人右侧 2 个**（x<0），另一侧连杆都在、舵机没画 | 机器人左侧 2 个舵机照右侧镜像装 |
| MG996R 圆舵盘 | 2 个舵机 | 只画了 1 个舵盘（机器人左侧，接右下颌连杆 JawLink） | 另一侧的 Part_33（左下颌连杆）怎么接 MG996R **要实装看**，可能同样用舵机自带圆舵盘 + M2×6 |
| 舌头 TongueSculpt | ×1 | 没画；只画了舌头舵机（下颌座上 3 个 MG90S 中的一个） | 舌头怎么接到舵机**要实装试** |
| 风扇 | — | 没画，只有支架 | 支架高 50 mm、后格栅 56.5 mm 见方，推测 **50 mm 风扇**；量支架孔距再买 |
| 外壳、牙齿、风扇支架的固定 | — | **一颗螺丝都没画** | 卡扣、胶，还是要另配螺丝，**要实装看** |
| 3 块 Pico PCB 的固定 | — | 没画 | 尼龙柱或扎带，看实物 |
| 眼部底板后侧 2 个 M3 孔（x=±69.7、y=8） | 有孔，框架上也有 Ø3.6 通孔 | 没画螺丝，RearPlate 正好盖在外面 | 可以压上，要在装 RearPlate 之前拧螺丝 |
| 下颌座第 7 个 M4 孔（x 9.9 到 19.9、y=-60.8、z=-92.4） | Ø5.35 深 10 | 没画螺丝；Part_19 的 Ø5.3 孔和它同轴 | 推测是舌头连杆的转轴，要 1 颗 M4 台阶螺丝；不装舌头可以不压 |
| 头骨框架其他 Ø4.4 孔（32 个） | 2026-11-04 查完 | 6 个接 FanBracket、14 个接外壳（RearPlate 10、FrontVent 4）、12 个无对应零件 | 风扇和外壳都可选，装时再压；无对应零件的先别压 |
| 眉毛底板 Part_4 | M4 ×12、M2 ×8 的孔 | 螺丝和热熔螺母都没画 | 必压，见图 3 下方的表；之前写的"舵机用自攻螺丝"作废 |

## C. 必须实装测试才能确定的

| # | 测什么 | 怎么判断 | 不行怎么办 |
|---|---|---|---|
| 1 | **舵机卡进眼部舵机座**的松紧（图 7） | 能压进去、不晃、座子不裂 | 紧：锉内壁；松：垫一层胶带或点热熔胶 |
| 2 | **打印舵盘压到舵机花键**（眼部 6 个，已坏 1 个 TopLidHorn） | 垂直压进去、舵盘不裂、转动不打滑 | 花键孔用 2 mm 钻头手捻扩一点；打滑就加一颗 M2.5×8 中心螺丝 |
| 3 | 舵机回中后**眼皮能闭严、眼球朝正前** | 90° 时眼皮闭合、眼球居中 | 拔下舵盘错一齿重装；还差一点就改 `config_eyes.py` 的范围 |
| 4 | **M3 台阶螺丝 + 螺母**（14 处） | 关节自由转、几乎不晃、扫 20 次不松 | 螺母槽太紧用烙铁把螺母烫进去；会松就点螺纹胶 |
| 5 | **M4 台阶螺丝进 M4 热熔螺母**（4 处） | 嘴唇主转轴转动顺、不晃 | 热熔螺母压歪了要重压 |
| 6 | **热熔螺母压装**（M2 ×16、M3 ×22、M4 ×16，2026-11-04 复核） | 垂直、和表面齐平、拧螺丝时不跟着转 | 先在废件或支撑上练手；歪了趁热拔出重压 |
| 7 | **M2.5×8 拧进 MG90S 输出轴**（嘴部 8 处）长度 | 能拧紧、不顶到舵机内部 | 顶底就在螺丝头下加垫片或换 M2.5×6 |
| 8 | **外六角 M3×8** 能不能拧到（8 处） | 5.5 mm 套筒能套上 | 个别换杯头 |
| 9 | **M4×8 代替 M4×6**（颧骨 → 上颌座 2 处） | 模型算出螺丝尖后面还有 7.6 mm 空孔 | 理论上没问题，装时确认能压紧 |
| 10 | **MG996R 两侧同步**：两个 MG996R 一起拉下巴 | 下巴张合不别劲、两个舵机不互相顶（电流不大、不发热） | 调 `config_mouth.py` 里 JL / JR 的 90° 对齐；**先只接一个舵机试** |
| 11 | **嘴唇连杆运动范围**：固件范围来自原版 | 每个舵机在范围两端都不顶死 | 改对应 config 的角度范围 |
| 12 | **TPU 眉毛**和连杆的配合 | 软件能被拉动、不脱出 | 视情况点胶 |
| 13 | **LateralFrame** 位置（见 B） | 能固定 LR 舵机，眼球左右转不晃 | 对着 Blender 里 LR 舵机的位置试装 |
| 14 | **线怎么走**：19+2 个舵机线 + 3 根 USB | 不被连杆夹、关节转到头不拉线 | 先装机构再理线，每个模块装完都手动扫一遍全行程 |
| 15 | **供电**：19 个 MG90S + 2 个 MG996R | 全部同时动不掉电、Pico 不重启 | 电源部分还没焊，焊之前算好电流（MG996R 堵转约 2.5 A） |

## 推荐顺序（结合上面）

1. 眼部：图 4 到 7（不用回中）→ 回中 → 图 8 到 10 → 测 C1 到 C3
2. 嘴部：热熔螺母 → 舵机 → 台阶螺丝关节（C4、C5）→ 回中 → 连杆
3. 眉毛：左侧照模型，右侧镜像；补 2 个舵机
4. 全部机构装完、通电扫一遍全行程 → 理线 → 最后装外壳、牙齿、FrontPlate（都可选）

## D. 底座和眼球（2026-11-01 补查）

**原版没有底座。** OBJ、3mf、打印包里都没有支架或脖子。
- 头摆不平：最低的是会动的下颌座（z = -106 mm），比头骨框架底面（z = -78 mm）还低 28 mm，直接放桌上会压住下巴。
- 更正（2026-11-06）：之前记的“x = ±30.5 两个向下圆柱接口”不是接口，是底板下方的两条竖筋（`|x|` 30.5 到 34.5）。真正可用的接口是头骨后下方的斜底板：厚 6.3 mm，倾斜 8°，六边形孔对边 50 mm，周围 4 个 8.0 × 19.6 × 2 mm 盲槽。支架 v2 用它转锁，见 `scripts/neck_stand/README.md`。
- 临时办法：把头架在盒子或书堆边上，下巴悬空在外面；或者用台钳 / 夹子夹住头骨框架后部。正式的可以自己画一个支架：底板 + 两根对准上面接口的立柱，高度让下巴离桌面 ≥ 35 mm。

**眼球原版只在参考装配模型里有**（Component74），3mf 打印文件里没有。plate9 的眼球 STL 是从装配模型导出来的。
- 尺寸：直径 32 mm，前后深 20 mm（比半球 16 mm 多出 4 mm，是背后和 EyeAdaptor 配合的部分）。
- 两个选择：打印 plate9 的眼球（白色 PLA，0.1 mm 层高，虹膜自己画或贴贴纸）；或者买 32 mm 的成品仿真眼球。**成品眼球背后没有接口**，要用胶粘到 EyeAdaptor 上，粘之前先确认眼球转到头不碰眼皮。

## E. 原作者的开源文件（2026-11-01 查）

来源：作者 Notion 页 [Robot Head α2.0.33](https://willcogley.notion.site/Robot-Head-2-0-33-1d724779b64d80568fd9cf1c7abd3e64)、[EyeMech ε3.2](https://willcogley.notion.site/EyeMech-3-1-1af24779b64d80b19edfdd795d4b90e5)（用 Notion API 读的正文），NMRobotics 商店。

**底座 / 脖子：没有。** 头部页面的材料清单和下载包都没有支架或脖子；作者其他开源项目里只有 Coglet（另一个小机器人，有颈部，但不通用）。→ 要自己做支架（见 D）。

**眼球：有。**
- 头部页面材料清单写的是 "Realistic eyes from NMRobots.com"（作者店里卖的成品眼球，配 ε 系列眼部机构）。Ultra Realistic 款 £42 到 52 一对。
- EyeMech ε3.2 下载包的 3mf 里有 **Component74 = 自己打印的眼球**（"Homemade 3D printed eyes"），和本头装配模型里的眼球是同一个零件，所以 plate9 的眼球 STL 就是官方的打印版眼球。
- 下载包已存到 `upstream/EyeMech_3.2_download/`（CC BY-NC-SA 4.0）。

**意外收获：眼部机构有官方组装说明书**（`EyeMech ε3.2/EYEMECH ε3.2 Assembly Document.pdf`，10 页，带线稿图）。本头的眼部是它的 snap-fit 版（ε2，零件名 SnapEyemech v20、LateralFrame、EyeCorePivotHolder 都对得上）。要点：
1. **官方顺序（组装流程已按它重排成图 4 到 11）**：先在桌上组眼球核心（X 轴子组件 A 装 LR 舵机 → 卡上 Y 轴 → 装**两个**中心枢轴座 → 松装 X 轴子组件 B），再从底面卡进底板 → 装眼球 → 装眼皮（上眼皮短连杆、下眼皮长连杆）→ **最后**放其余 5 个舵机，用**舵机压扣（retainer）**扣住。
2. 所以 **EyeCorePivotHolder_v2 是 X 轴件 A（方框装 LR 舵机），LateralFrame 是 X 轴件 B（2026-11-05 按形状更正）**；**EyeCorePivotHolder 原版和 v2 两个都要装**（左右各一），不是备件。B 节里"v2 是改版"的说法作废。
3. 回中：眼球朝前、眼皮在中间合上；舵盘装好后**拧舵盘螺丝**固定。UD 舵机不好够，官方建议先把它拆出来，记住位置，在外面装好舵盘再放回去。
4. 下载包里有 **ServoSizingPlate（舵机尺寸测试块）**：打一块，看哪个孔最适合你的舵机（越紧越好但别压坏），对应字母 A / B 选零件版本。之后找朋友重打时可以一起打一块。
5. 原版 Pico 接法（官方眼部板）：VBUS 接全部舵机电源、GP10 LR、GP11 UD、GP12 TL、GP13 BL、GP14 TR、GP15 BR。**和本头 PCB 的引脚不同**，本头以 `firmware/config_eyes.py` 为准。

**头部页面材料清单里的其他信息：**
- 风扇：**50×50×10 mm**（和 D 的推测一致）
- 电源：**5 V 10 A**
- 台阶螺丝：约 25 颗 M3、约 10 颗 M4（比模型画的 14 / 4 多，可能眉毛等没画的地方也用），"optionally use standard M3/M4 with lock nut"
