letteryzzm/emotionbot/print_package/给朋友打印_2026-11-01/打印说明.txt

机器人头 补打零件 —— 拓竹（Bambu Studio）打印说明
2026-11-01

所有文件单位都是 mm，已经摆好打印方向。导入后：
  · 不要缩放（100%）
  · 不要点"自动朝向"
  · 弹出"是否按英寸缩放"之类的提示，选"否"

============================================================
一、颈部支架  NeckStand_颈部支架_x1.stl   × 1
============================================================
【零件参数】
  尺寸        140 × 200 × 115 mm（长 × 宽 × 高）
  实体体积    约 295 cm³
  底面        整块平板贴床，接触面积约 280 cm²
  预计用料    约 180 到 220 g PLA（按 20% 填充估算）
  预计时间    约 6 到 8 小时（P1S / X1C 标准速度）
  结构        6 mm 厚底板 + 两根 12 mm 厚的斜立柱 + 后横墙 + 前横梁
              立柱上端各有一个 5 × 3.5 mm 的横向扎带孔（不用支撑，能直接搭桥）
  平台要求    ≥ 200 mm（A1 mini 放不下；A1 / P1S / X1C 都可以）

【拓竹设置】
  打印机      P1S / X1C / A1，0.4 mm 喷嘴
  耗材        Bambu PLA Basic / PLA Matte，任意颜色
  工艺预设    0.20mm Standard
  墙层数      4
  顶部壳层    5    底部壳层    4
  稀疏填充    20%，图案 网格（Grid）或 螺旋体（Gyroid）
  支撑        关闭（不需要）
  Brim        开启：外侧 Brim，宽度 5 mm
              （底板面积大，角落容易翘边）
  打印板      纹理 PEI 板，或者冷板加一层胶
  摆放        就按导入的方向：底板贴床、立柱朝上。不要旋转
  其他        默认即可

【注意】
  · 打印前看一眼切片预览：立柱顶端是斜面，属于正常设计（为了贴合头骨底部）。
  · 角落翘边的话：加大 Brim 到 8 mm，或者热床温度 +5 °C。

============================================================
二、眼球  Eyeball_官方_x2.stl   × 2（文件里是 1 个，打 2 个）
============================================================
来源：Will Cogley 官方 EyeMech ε3.2 下载包里的打印版眼球（CC BY-NC-SA 4.0）。

【零件参数】
  尺寸        直径 32 mm，高 19.9 mm
              （正面是半球，背面是平的，有和眼球连接件配合的接口）
  实体体积    约 8.5 cm³ / 个
  底面        背面平面朝下，接触面积约 2.8 cm²
  预计用料    约 8 到 10 g / 个
  预计时间    两个一起打约 1.5 到 2.5 小时（0.1 mm 层高）

【拓竹设置】
  数量        在拓竹里右键 →"克隆"，克隆 1 个，凑成 2 个；放在同一块板上
  耗材        PLA 白色（Bambu PLA Basic White / PLA Matte Ivory White）
  工艺预设    0.08mm Extra Fine 或 0.12mm Fine；有自定义就把层高改成 0.10 mm
              层高越小，球面越光滑
  墙层数      3
  顶部壳层    默认    底部壳层    默认
  稀疏填充    15%
  支撑        关闭（平面朝下，球面朝上，不需要支撑）
  Brim        开启：外侧 Brim，宽度 3 mm（底面小，防止打到一半被喷嘴碰倒）
  摆放        就按导入的方向：平面朝下。不要旋转
  其他        可以开"平滑 Z 缝"或者把 Z 缝位置设成"背面 / 对齐"，球面更好看

【打完】
  · 去掉 Brim，用细砂纸（400 → 800 → 1500 目）把球面打磨光滑。
  · 虹膜和瞳孔之后自己画，或者贴眼睛贴纸。

============================================================
三、顺便一起打的（可以和眼球放同一块板）
============================================================
  TopLidHorn_眼皮舵盘_x3.stl    文件里排了 4 个，全打
    PLA 任意色，0.20mm Standard，稀疏填充 100%，墙层数 4
    支撑：开启，类型 树状（自动）
    零件很小很薄，去支撑时用镊子，小心别掰断

  ServoSizingPlate_舵机尺寸测试块_x1.stl   × 1
    PLA，0.20mm Standard，默认设置，不要支撑

============================================================
四、拼板建议
============================================================
  · 第 1 块板：颈部支架（单独一块板，它占满大半个平台）
  · 第 2 块板：眼球 ×2 + 眼皮舵盘 ×4 + 测试块
    拓竹里可以给不同零件单独设置参数：
    在左边对象列表里右键零件 → 添加设置 → 层高 / 填充
    如果嫌麻烦，就把眼球单独放一块板，按 0.08 / 0.12 预设打
