letteryzzm/emotionbot/print_package/给朋友打印_2026-11-01/预览_支架.png

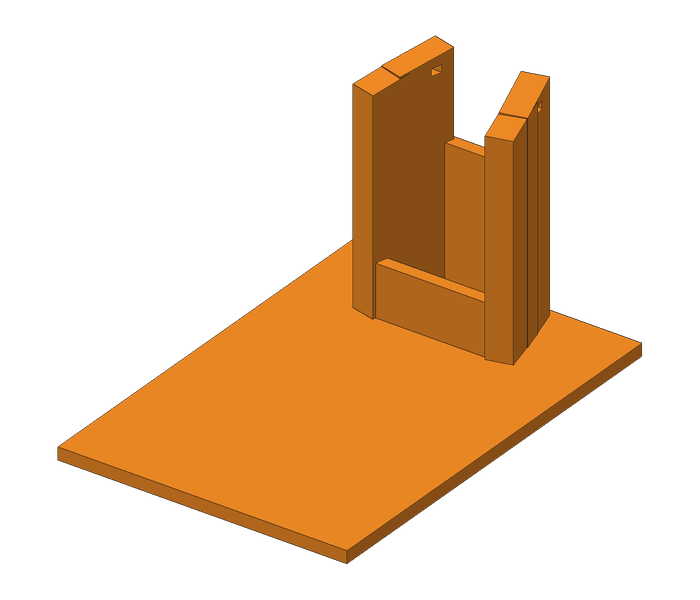
print_package/给朋友打印_2026-11-01/预览_支架.png
