letteryzzm/emotionbot/emo_bench/results/fast_layer.md

### ravdess（完整测试 1248 条 / 子集 56 条，7 类，随机 UA 14.3）

| 方案 | 完整 UA | 完整 macro-F1 | 子集 UA | 子集 macro-F1 | 子集 n |
|---|---|---|---|---|---|
| A: SenseVoice | 49.3 | 43.3 | 60.7 | 60.2 | 56 |
| A: emotion2vec+ ⚠ | 91.9 | 91.3 | 89.3 | 89.1 | 56 |
| V: EmotiEffNet-B0 零样本 | 63.0 | 59.4 | 58.9 | 50.8 | 56 |
| 快层 SenseVoice + EmotiEffNet | 66.1 | 62.4 | 73.2 | 72.0 | 56 |
| 快层 emotion2vec+ + EmotiEffNet ⚠ | 92.6 | 92.0 | 92.9 | 92.6 | 56 |
| 快层 三个都用 ⚠ | 91.7 | 90.8 | 91.1 | 90.8 | 56 |
| 慢层 qwen3.8-omni-flash av | – | – | 66.1 | 64.3 | 56 |
| 混合 = 快层(SV+ENet) + 慢层 | – | – | 69.6 | 68.4 | 56 |
| 混合 = 快层(三个) + 慢层 ⚠ | – | – | 92.9 | 92.8 | 56 |

### cremad（完整测试 1856 条 / 子集 54 条，6 类，随机 UA 16.7）

| 方案 | 完整 UA | 完整 macro-F1 | 子集 UA | 子集 macro-F1 | 子集 n |
|---|---|---|---|---|---|
| A: SenseVoice | 54.5 | 51.0 | 61.1 | 60.2 | 54 |
| A: emotion2vec+ ⚠ | 76.0 | 75.6 | 83.3 | 83.5 | 54 |
| V: EmotiEffNet-B0 零样本 | 52.8 | 50.6 | 57.4 | 52.9 | 54 |
| 快层 SenseVoice + EmotiEffNet | 61.7 | 61.0 | 64.8 | 65.0 | 54 |
| 快层 emotion2vec+ + EmotiEffNet ⚠ | 77.4 | 76.9 | 79.6 | 79.5 | 54 |
| 快层 三个都用 ⚠ | 77.6 | 77.1 | 81.5 | 81.0 | 54 |
| 慢层 qwen3.8-omni-flash av | – | – | 53.7 | 48.6 | 54 |
| 混合 = 快层(SV+ENet) + 慢层 | – | – | 55.6 | 52.8 | 54 |
| 混合 = 快层(三个) + 慢层 ⚠ | – | – | 81.5 | 81.1 | 54 |

### meld（完整测试 2610 条 / 子集 56 条，7 类，随机 UA 14.3）

| 方案 | 完整 UA | 完整 macro-F1 | 子集 UA | 子集 macro-F1 | 子集 n |
|---|---|---|---|---|---|
| A: SenseVoice | 28.4 | 28.7 | 30.4 | 22.8 | 56 |
| A: emotion2vec+ ⚠ | 29.8 | 28.5 | 28.6 | 22.9 | 56 |
| V: EmotiEffNet-B0 零样本 | 21.6 | 18.2 | 26.8 | 23.8 | 56 |
| 快层 SenseVoice + EmotiEffNet | 28.3 | 28.2 | 28.6 | 20.9 | 56 |
| 快层 emotion2vec+ + EmotiEffNet ⚠ | 31.4 | 30.0 | 26.8 | 22.3 | 56 |
| 快层 三个都用 ⚠ | 31.2 | 31.3 | 30.4 | 26.3 | 56 |
| 慢层 qwen3.8-omni-flash avt | – | – | 55.1 | 54.6 | 53 |
| 混合 = 快层(SV+ENet) + 慢层 | – | – | 45.6 | 46.5 | 53 |
| 混合 = 快层(三个) + 慢层 ⚠ | – | – | 32.3 | 28.8 | 53 |
