letteryzzm/emotionbot/docs/开发日志-2026-11-05.md

# 开发日志 · 2026-11-05（黑客松 Day 0 准备）

负责人：郑子瑜（感知 + 中枢决策）
机器：开发机 Windows 10 / RTX 3060 Laptop 6GB；演示机（另一台）Linux / RTX 4060 Laptop 8GB

---

## 一、今天完成了什么

### 1. 实时闭环代码落地

| 模块 | 文件 | 内容 |
|---|---|---|
| 感知 | `perception/asr_ser.py` | SenseVoiceSmall 封装，一次推理出文本 + 情感标签，`ban_emo_unk=True`，硬标签平滑成 0.7/0.3 概率 |
| 感知 | `perception/ser.py` | emotion2vec+ 封装，9 类映射到 7 类，输出归一化概率 |
| 感知 | `perception/pipeline.py` | VAD 切句 → ASR/SER/文本/FER 四路并发 → 融合 → 事件回调；含回声门控与异常兜底 |
| 融合 | `perception/fusion.py` | 置信度加权对数概率融合、缺失模态重归一化、**字面/语气矛盾检测** |
| 决策 | `agent/state.py` | EMA 情绪状态平滑；高置信事件用 α≥0.75，矛盾事件直接透传；标签滞回 |
| 决策 | `agent/policy.py` | 情绪 → 表情/强度/时长的规则表（含 `concerned` 矛盾表情） |
| 决策 | `agent/dialogue.py` | 按情绪选模板句，TTS 回应 |
| 输出 | `agent/tts.py` | edge-tts → miniaudio → sounddevice；离线兜底；逐块音量包络驱动嘴形 |
| 运行时 | `app/run.py` | 装配所有组件，25Hz 头桥接、单槽 TTS 队列、优雅退出 |
| 界面 | `app/server.py` + `app/dashboard.html` | 标准库 HTTP 仪表盘：三模态概率、矛盾横幅、2D 表情、延迟、时间线 |

测试：`pytest -q` **65 passed**（融合缺失模态/矛盾、策略表、状态平滑、仪表盘接口、回声门控、事件记录）。

### 2. 环境从零搭好（开发机）

- 安装 Python 3.11.9，创建 `.venv`
- torch 2.5.1 + cu121，CUDA 可用（RTX 3060 6GB）
- funasr 1.4.21 / emotiefflib 1.1.1 / opencv 5.0.0 / sounddevice / miniaudio / edge-tts / pyttsx3 / pyserial
- 补充安装 `torchaudio==2.5.1`（FunASR 提 fbank 必需）和 `timm`（emotiefflib 必需）
- `scripts/selfcheck.py` **全部通过**：GPU、依赖、摄像头（640×480）、麦克风枚举、16kHz 单声道、外网、磁盘

### 3. 模型下载与真实推理验证

下载到 `D:\emo_models`：

- SenseVoiceSmall：897 MB
- emotion2vec_plus_large：1.9 GB

新增 `scripts/smoke_models.py`，用 edge-tts 合成一句话直接走项目封装类推理：

```
输入: 3.53s「今天天气不错，我有点想出去走走」
[ASR] 1154ms  text='今天天气不错，我有点想出去走走。'
[ASR] 情感 neutral 0.70
[SER] 913ms  happy 1.00（7 类概率和 = 1）
显存: 1.51 GB，峰值 1.59 GB
SMOKE OK
```

结论：文字识别正确，两路模型在 GPU 上正常工作，显存占用远低于 8GB 预算。

### 4. Linux 演示机适配

演示机是 Linux + RTX 4060 8GB，之前代码和设备脚本全是 Windows 假设，今天全部改掉：

| 位置 | 改动 |
|---|---|
| `head/client.py` | 串口发现改为三平台统一 `list_ports`，优先 USB VID `0x2E8A`；Linux 自动识别 `/dev/ttyACM*` |
| `agent/tts.py` | 离线兜底增加 espeak-ng（Linux），保留 Windows SAPI；支持 `EMOBOT_AUDIO_OUT` 指定输出声卡 |
| `scripts/selfcheck.py` | 模型目录/磁盘检查跨平台；新增默认输出设备检查、dialout 权限提示 |
| `scripts/prefetch_models.py` | 默认目录按平台区分（Windows `D:/emo_models`，Linux `~/emo_models`） |
| `scripts/setup_env.sh` | 新增 Linux 一键脚本：Python 3.11 → venv → cu124 torch → 依赖 → 模型 → 自检 |
| `scripts/setup_env.ps1`、`setup_env.sh` | 补锁 `transformers==4.57.6`、`torchaudio`、`timm` |
| `README.md` | 增加 Linux 演示机操作说明 |

### 5. 文档

- `docs/作品简介.md`：给主办方的介绍（一句话 / 200 字 / 完整版 / 3 分钟演示脚本 / 场景 / 分工）
- `docs/实时管道-队友接口.md`：T5 音频 UDP 8770 格式、播报回传方案、Pico 端口约定

---

## 二、今天踩的坑与修复

| 问题 | 现象 | 修复 |
|---|---|---|
| transformers 5.x | 启动时提示 `PyTorch >= 2.6 is required but found 2.5.1`，模型全部不可用 | 锁 `transformers==4.57.6`，写进两套安装脚本 |
| funasr 安装失败 | `emotion2vec` 不是 PyPI 包，和 funasr 写在一条命令里导致整条失败 | 拆成 `funasr` 和 TTS 两条命令 |
| Windows 证书库损坏 | `import edge_tts` 抛 `ASN1: NOT_ENOUGH_DATA` | `ensure_ssl_context()` 用 certifi 兜底 |
| PowerShell 读脚本乱码 | 无 BOM 的 UTF-8 被按 GBK 解析，字符串未终止 | 脚本改存 UTF-8 with BOM |
| `-ExecutionPolicy Bypass` | 被安全策略拦截 | 移除该参数，改用 `powershell -NoProfile -File` |
| GBK 控制台 | 打印特殊字符直接崩溃 | stdout/stderr 统一 reconfigure 为 UTF-8 |
| FunASR 缺 fbank 后端 | `ImportError: torchaudio is not installed` | 安装匹配版本的 `torchaudio==2.5.1+cu121` |
| emotiefflib 预热失败 | `No module named 'timm'` | 安装 `timm` 并加入依赖 |
| 蓝牙串口 | 枚举到 4 个蓝牙 COM 口，逐个探测超时 | 跳过 `vid is None` 的端口 |
| 状态卡死 | 矛盾事件后 EMA 过重，后续情绪切不回来 | 峰值 ≥0.6 时 α 提到 0.75，矛盾事件透传 |

---

## 三、当前状态

**已验证**
- 离线推理链路：模型加载、ASR、SER、GPU 显存、7 类概率归一化
- 决策/融合逻辑：65 个单元测试
- Windows 开发环境：selfcheck 全绿

**未验证**
- 真实麦克风的连续实时链路（VAD 切句、端到端延迟、真人矛盾句）
- 摄像头 FER 与三模态融合
- TTS 回声门控实测
- 真机头（Pico）串口与舵机
- Linux 演示机环境（只完成代码适配，未在 4060 机器上实跑）

**已知现象**
- emotion2vec 会把 TTS 合成的中性句判成 `happy 1.00`，属于播音腔韵律导致，不代表模型错误。矛盾检测必须用真人语音验证。

---

## 四、下一步

1. 麦克风到位后，跑真声链路：`python -m app.run --source mic --sim --no-face`
2. 自录 10–20 句"字面积极、语气消极"的句子，验证矛盾检测（可先用手机录音 + `--source file` 替代）
3. 开摄像头验证 FER 与模态缺失场景
4. 在 4060 Linux 演示机上跑 `setup_env.sh` + `smoke_models.py`，提前暴露环境问题
5. 与队友对齐 T5 UDP 音频格式，拿到三块 Pico 的串口号
6. 用 `--sim` 模式录制备份演示视频

---

## 五、常用命令

```bash
# 环境自检
python scripts/selfcheck.py

# 模型真实推理
EMOBOT_MODEL_DIR=D:/emo_models python scripts/smoke_models.py

# 实时链路（麦克风 + 仿真头）
EMOBOT_MODEL_DIR=D:/emo_models python -m app.run --source mic --sim --no-face

# 离线回放
python -m app.run --source file --wav demo.wav --loop --sim

# 不加载模型，只调界面
python -m app.run --stub --sim

# 测试
python -m pytest -q
```
