letteryzzm/emotionbot/(list of files, drawings)

Other design files:
pcb/ProDoc_Eyes_Brow_Neck_2025-04-16.epro
pcb/ProDoc_Mouth Board_2025-04-16.epro
