letteryzzm/emotionbot/firmware/config_brows.py

# 眉毛板：同一块 Eyes_Brow_Neck PCB，原 Brows.py 的引脚
# 原版 Brows.py 的 mode 开关含义和眼部板相反（0 时乱扫），这里不接开关
ROLE = "brows"
SPEED_DEG_S = 600
CAL_PIN = None
CAL_LEVEL = 1
SERVOS = {
    # L = 面对机器人时的左手边（机器人自己的右侧），见 docs/舵机接线与上电检查.html
    "LO": (8, 65, 135, 100),   # 眉外侧 面对时左手边 80=下 120=上
    "LI": (9, 115, 45, 80),    # 眉内侧 面对时左手边 100=下 60=上
    "RI": (13, 65, 135, 100),  # 眉内侧 面对时右手边
    "RO": (12, 115, 45, 80),   # 眉外侧 面对时右手边
}
