letteryzzm/emotionbot/firmware/config_eyes.py

# 眼部板：Eyes_Brow_Neck PCB，原 eyes.py 的引脚和范围
# name: (GPIO, 角度a, 角度b, rest)。a/b 只用来限幅，语义在 head/actuators.py
ROLE = "eyes"
SPEED_DEG_S = 600
CAL_PIN = 1      # 原版 mode 开关，=1 时校准
CAL_LEVEL = 1
SERVOS = {
    "LR": (8, 40, 140, 90),    # 眼球左右，角度增大 = 看向机器人左侧
    "UD": (9, 60, 160, 90),    # 眼球上下，角度增大 = 向上
    # L = 面对机器人时的左手边（机器人自己的右侧），见 docs/舵机接线与上电检查.html
    "TL": (13, 90, 160, 160),  # 上眼皮 面对时左手边 90=闭 160=睁
    "BL": (12, 90, 30, 30),    # 下眼皮 面对时左手边 90=闭 30=睁
    "TR": (11, 90, 30, 30),    # 上眼皮 面对时右手边
    "BR": (10, 90, 140, 140),  # 下眼皮 面对时右手边
}
