letteryzzm/emotionbot/firmware/config_mouth.py

# 嘴部板：Mouth Board PCB，原 Mouth.py / MouthMaster.py 的引脚，范围取自原 poses
ROLE = "mouth"
SPEED_DEG_S = 600
CAL_PIN = 28     # 原版 mode 开关，=0 时全部 90°
CAL_LEVEL = 0
SERVOS = {
    # 左右和位置见 docs/舵机接线与上电检查.html。JL/JR 的 L 在机器人右侧，其余 L 在机器人左侧
    "JL": (4, 90, 35, 90),     # 下颌（机器人右侧）MG996R 90=闭 50=张
    "JR": (5, 90, 145, 90),    # 下颌（机器人左侧）MG996R 90=闭 130=张
    "LUL": (6, 110, 40, 75),   # 上唇 机器人左 ULLLinkA 110=下 40=上
    "LUR": (7, 70, 140, 105),  # 上唇 机器人右 Part_35
    # 下唇 a/b 按连杆方向推算：角度增大 = 机器人左侧下唇往下，所以 a=下 b=上（u=1 上抬）
    "LLL": (8, 110, 55, 82),   # 下唇 机器人左 Part_27 110=下 55=上
    "LLR": (9, 60, 110, 85),   # 下唇 机器人右 Part_38 60=下 110=上
    "CUL": (10, 100, 45, 90),  # 嘴角上下 机器人左 Part_31 100=撇嘴 60=笑
    "CUR": (11, 75, 120, 80),  # 嘴角上下 机器人右 Part_42
    "CLL": (12, 90, 135, 90),  # 嘴角前后 机器人左 Part_32 90=窄 120=宽
    "CLR": (13, 90, 50, 90),   # 嘴角前后 机器人右 Part_43
    "TON": (14, 130, 55, 130), # 舌头 130=下 55=上
    "EXA": (15, 80, 100, 90),  # 原版未使用的备用口，装好后确认用途
}
