letteryzzm/emotionbot/scripts/tune_server.py

"""网页调试台：逐组通电、小步转动、记录现象。写入 outputs/tune_log.jsonl，和 tune.py 同一份日志。

  .venv/bin/python scripts/tune_server.py --sim  # 先用仿真练习保存与重放
  .venv/bin/python scripts/tune_server.py        # 真机，只听 127.0.0.1:8770

运行时独占三块 Pico 的串口，不要同时跑 tune.py / servo_step.py。
启动时只读角度，不让舵机动，也不卸力。

每秒检查一次串口。USB 断开时 Pico 可能靠 5V 继续跑，舵机还在受力，
所以板子重新出现时先发 X。
"""
import argparse
import glob
import json
import math
import sys
import threading
import time
import urllib.request
from http.server import BaseHTTPRequestHandler, ThreadingHTTPServer
from pathlib import Path
from typing import NamedTuple

ROOT = Path(__file__).resolve().parent.parent
sys.path.insert(0, str(ROOT))
from head.actuators import BY_NAME, center, save_center, to_angles  # noqa: E402
from head.calibration_session import CalibrationControls, PositionBook  # noqa: E402
from camera.behavior import gaze_to_u  # noqa: E402
from head.expressions import EXPRESSIONS, expression  # noqa: E402
from head.eye_motion import EYES, eye_frames, eye_pose  # noqa: E402
from head.hub import load_verified  # noqa: E402
from head.pose_library import DEFAULT_PATH, PoseError, PoseLibrary, label_key, number, validate_angles  # noqa: E402

LOG = ROOT / "outputs" / "tune_log.jsonl"
PORT = 8770
SPEED = 300
MAX_STEP = 5
JAW_SKEW = 5   # JL + JR 偏离 180 的上限，两个 MG996R 不能互相顶
SWING_AMPS = (15, 30)
BOARDS = ("eyes", "brows", "mouth")
# 2026-11-13 用户要求恢复 LLR 普通标定；保留未接线通道隔离。
BLOCKED = {"EXA": "未接舵机的备用通道"}

# 从下到上，和 docs/舵机接线与上电检查.html 的嘴部图一致
GROUPS = [
    ("舌头", ["TON"]), ("下唇", ["LLL", "LLR"]), ("嘴角前后", ["CLL", "CLR"]), ("下巴", ["JL", "JR"]),
    ("嘴角上下", ["CUL", "CUR"]), ("上唇", ["LUL", "LUR"]),
    ("眉外侧", ["LO", "RO"]), ("眉内侧", ["LI", "RI"]),
    ("下眼皮", ["BL", "BR"]), ("上眼皮", ["TL", "TR"]), ("眼球左右", ["LR"]), ("眼球上下", ["UD"]),
]


INTENSITIES = (0.3, 0.6, 1.0)
GAZE = set(EYES)   # 每个表情都驱动整个眼部，UD 带补偿


# 视觉跟踪：只读 camera.web 的结果，不开摄像头。只跟有实测范围的 LR
VISION_URL = "http://127.0.0.1:8000"
TRACK_SERVO = "LR"
TRACK_HZ = 10
TRACK_STEP = 3        # 每拍最多转的度数，10Hz 时是 30°/s
TRACK_DEADBAND = 1    # 差不到这么多就不发，避免舵机抖
TRACK_ALPHA = 0.4
TRACK_LOST = 3.0      # 秒，看不到脸这么久才慢慢回中心
_no_proxy = urllib.request.build_opener(urllib.request.ProxyHandler({}))


def read_vision(path):
    with _no_proxy.open(VISION_URL + path, timeout=0.3) as r:
        return json.load(r)


class Refused(Exception):
    pass


class Frame(NamedTuple):
    """眼部动画的一帧：自己的速度和停留时间"""
    goal: dict
    speed: float
    hold: float


def expression_steps(name, k):
    """表情拆成一组一组的目标角度，只含表情写到的舵机和视线，其他舵机不通电"""
    ang = {**to_angles(expression(name, k)), **eye_pose(name, k)}
    wanted = set(EXPRESSIONS[name]) | GAZE
    steps = []
    for label, names in GROUPS:
        goal = {n: round(ang[n], 1) for n in names if n in wanted}
        if goal:
            steps.append({"label": label, "goal": goal})
    return steps


def tested_ranges(path=LOG):
    """日志里真机走过的角度范围。没走过的要提醒，不代表走过的就没问题"""
    seen = {}
    if not path.exists():
        return seen
    for line in path.read_text().splitlines():
        r = json.loads(line)
        if r.get("type") == "cmd" and r["cmd"].startswith("S "):
            for kv in r["cmd"].split()[1:]:
                n, _, v = kv.partition("=")
                lo, hi = seen.get(n, (float(v), float(v)))
                seen[n] = (min(lo, float(v)), max(hi, float(v)))
    return seen


def direction(name):
    a = BY_NAME[name]
    return 1 if a.b > a.a else -1


def clip(name, deg):
    a = BY_NAME[name]
    return float(min(max(deg, min(a.a, a.b)), max(a.a, a.b)))


def default_log(entry):
    LOG.parent.mkdir(exist_ok=True)
    with LOG.open("a") as f:
        f.write(json.dumps(entry, ensure_ascii=False) + "\n")


def discover(skip=()):
    import serial

    links = {}
    for p in glob.glob("/dev/serial/by-id/*MicroPython*"):
        if p in skip:
            continue
        try:
            s = serial.Serial(p, 115200, timeout=0.5, write_timeout=0.5, exclusive=True)
        except serial.SerialException as e:
            for link in links.values():
                link.close()
            raise Refused(f"串口不可用 {p}；请先关闭其他控制进程：{e}") from e
        time.sleep(0.1)
        s.reset_input_buffer()
        s.write(b"?\n")
        line = s.readline().decode(errors="ignore").strip()
        if line.startswith("ROLE "):
            links[line.split()[1]] = s
        else:
            s.close()
    return links


class Bench(CalibrationControls):
    save_center = staticmethod(save_center)

    log_path = LOG
    vision = staticmethod(read_vision)

    def __init__(self, links, log=default_log, settle=0.4, pace=1.0, rediscover=None,
                 library_path=DEFAULT_PATH, mode="hardware", blocked=None, llr_unloaded=False):
        self.links, self.log, self.settle, self.pace = links, log, settle, pace
        self.rediscover = rediscover
        self.lock = threading.Lock()
        self.stop = threading.Event()
        self.job = None        # 正在跑的回中或摆动
        self.script = None     # 当前表情的分步计划
        self.tracking = None   # 视觉跟踪的状态，None 是没开
        self.powered = set()   # 这个服务通过电的舵机；启动前已通电的不在内
        self.held = set()      # 用户要求一直保持的舵机，只有全部卸力才放开
        self.angles = {}
        self.error = ""
        self.mode = mode
        self.blocked = dict(BLOCKED if blocked is None else blocked)
        self.llr_unloaded = llr_unloaded  # 兼容专用短时检查入口，不影响普通标定权限。
        self.llr_probe = None
        self.library = PoseLibrary(library_path, mode=mode)
        self.preview = None
        self._init_calibration(Path(library_path).with_name(Path(library_path).stem + "-positions.json"))
        for board in list(links):
            self._read(board)

    def _record(self, kind, **kw):
        self.log({"t": time.strftime("%Y-%m-%d %H:%M:%S"), "type": kind, **kw})

    def _check_enabled(self, names):
        for n in names:
            if n in self.blocked:
                raise Refused(f"{n} 已禁用：{self.blocked[n]}")

    def _ask(self, board, line, *, unloaded_probe=False):
        parts = line.split()
        if unloaded_probe:
            if not self.llr_unloaded or board != "mouth" or line != "O LLR":
                raise Refused("空载检查只允许 LLR 到 90°")
        elif parts[0] in ("S", "O"):
            self._check_enabled(p.split("=")[0] for p in parts[1:])
        elif parts[0] in ("R", "C"):
            self._check_enabled(n for n, a in BY_NAME.items() if a.board == board)
        link = self.links.get(board)
        if link is None:
            raise Refused(f"{board} 板不在线")
        try:
            link.write((line + "\n").encode())
            return link.readline().decode(errors="ignore").strip()
        except Exception as e:
            self._lost(board)
            raise Refused(f"{board} 板串口断开：{e}")

    def _lost(self, board):
        # 跟踪值可能已回到 90，必须重新通电。舵机可能还在受力，所以要提醒
        link = self.links.pop(board, None)
        if link is not None and hasattr(link, "close"):
            try:
                link.close()
            except Exception:
                pass
        self.stop.set()
        self.powered -= {n for n in self.powered if BY_NAME[n].board == board}
        self.held -= {n for n in self.held if BY_NAME[n].board == board}
        self.error = f"{time.strftime('%H:%M:%S')} {board} 板掉线，舵机可能还在受力。听到嗡嗡声就断 5V"

    def _read(self, board):
        reply = self._ask(board, "G")
        try:
            if not reply.startswith("A "):
                raise ValueError(reply)
            got = {k: float(v) for k, v in (kv.split("=") for kv in reply.split()[1:])}
            expected = {n for n, a in BY_NAME.items() if a.board == board}
            if set(got) != expected or not all(math.isfinite(v) for v in got.values()):
                raise ValueError(reply)
        except ValueError as e:
            raise Refused(f"{board} 角度回报无效：{reply}") from e
        self.angles.update(got)
        return got

    def beat(self):
        """每秒一次：发现掉线，并在板子回来时马上卸力"""
        with self.lock:
            for board in list(self.links):
                try:
                    if not self._ask(board, "?").startswith("ROLE "):
                        self._lost(board)
                except Refused:
                    pass
            if self.rediscover is None or set(BOARDS) <= set(self.links):
                return
            skip = {getattr(link, "port", None) for link in self.links.values()}
            for board, link in self.rediscover(skip).items():
                self.links[board] = link
                reply = self._ask(board, "X")
                self._read(board)
                self.error = f"{time.strftime('%H:%M:%S')} {board} 板已重连并卸力。查一下掉线原因再通电"
                self._record("cmd", board=board, cmd="X", reply=f"重连后自动卸力 {reply}", angles=self.angles)

    def _busy(self):
        return self.job is not None and self.job.is_alive()

    def _start(self, legs, additive=False, done=None, dwell=0.2):
        # 在第一块板收到动作前检查整段计划，避免执行到一半才遇到禁用通道。
        for leg in legs:
            self._check_enabled(leg.goal if isinstance(leg, Frame) else leg)
        self.stop.clear()
        self.job = threading.Thread(target=self._legs, args=(legs, additive, done, dwell), daemon=True)
        self.job.start()

    def _legs(self, legs, additive=False, done=None, dwell=0.2):
        # 一步里每块板发一条 S，几块板同时动。等待时不占锁，卸力才能马上插进来
        try:
            for leg in legs:
                frame = leg if isinstance(leg, Frame) else None
                goal = frame.goal if frame else leg
                speed = frame.speed if frame else SPEED
                by_board = {}
                for n, v in goal.items():
                    by_board.setdefault(BY_NAME[n].board, {})[n] = v
                now = {}
                with self.lock:
                    if self.stop.is_set():
                        return
                    for board, part in by_board.items():
                        now.update(self._read(board))
                        self._ask(board, f"V {speed}")
                        line = "S " + " ".join(f"{n}={v:g}" for n, v in part.items())
                        reply = self._ask(board, line)
                        if reply != "OK":
                            raise Refused(reply)
                        if additive:
                            self.powered |= set(part)
                        self._record("cmd", board=board, cmd=line, reply=reply, angles=self.angles)
                dist = max(abs(v - now[n]) for n, v in goal.items())
                if self.stop.wait(self.pace * (frame.hold if frame else dist / SPEED + dwell)):
                    return
                with self.lock:
                    for board in by_board:
                        self._read(board)
            if done:
                done()
        except (Refused, OSError, ValueError) as e:
            self.error = str(e)

    def expr(self, name, intensity):
        """准备一个表情，不动舵机"""
        with self.lock:
            if self._busy():
                raise Refused("上一个动作还没结束")
            if name not in EXPRESSIONS:
                raise Refused(f"没有这个表情：{name}")
            if intensity not in INTENSITIES:
                raise Refused(f"强度只能是 {INTENSITIES}")
            seen = tested_ranges(self.log_path)
            steps = expression_steps(name, intensity)
            for s in steps:
                s["new"] = [n for n, v in s["goal"].items()
                            if n not in seen or not seen[n][0] <= v <= seen[n][1]]
            self.script = {"name": name, "intensity": intensity, "steps": steps, "i": 0}

    def _finish(self):
        sc = self.script
        if sc is None:
            return
        lines = [f'{s["label"]}: S ' + " ".join(f"{n}={v:g}" for n, v in s["goal"].items()) for s in sc["steps"]]
        self._record("recipe", name=f'{sc["name"]} 强度 {sc["intensity"]}', text="分步走完，现象看过程记录", steps=lines)

    def expr_next(self):
        with self.lock:
            sc = self.script
            if self._busy():
                raise Refused("上一个动作还没结束")
            if sc is None or sc["i"] >= len(sc["steps"]):
                raise Refused("先选一个表情")
            step = sc["steps"][sc["i"]]
            sc["i"] += 1
            last = sc["i"] == len(sc["steps"])
            self._start([step["goal"]], additive=True, done=self._finish if last else None)

    def expr_all(self):
        with self.lock:
            sc = self.script
            if self._busy():
                raise Refused("上一个动作还没结束")
            if sc is None or sc["i"] >= len(sc["steps"]):
                raise Refused("先选一个表情")
            legs = [s["goal"] for s in sc["steps"][sc["i"]:]]
            sc["i"] = len(sc["steps"])
            self._start(legs, additive=True, done=self._finish)

    def _pose(self, name, k, active):
        """这个表情的完整目标：写到的舵机加视线，之前动过的回 rest。保持的舵机不碰"""
        ang = {**to_angles(expression(name, k)), **eye_pose(name, k)}
        names = (set(EXPRESSIONS[name]) | GAZE | active) - self.held - {"EXA"}
        return {n: round(ang[n], 1) for n in sorted(names)}

    def expr_go(self, name, intensity):
        """整个表情一起做"""
        with self.lock:
            if self._busy():
                raise Refused("上一个动作还没结束")
            if name not in EXPRESSIONS or intensity not in INTENSITIES:
                raise Refused("表情或强度不对")
            goal = self._pose(name, intensity, self.powered)
            done = lambda: self._record("recipe", name=f"{name} 强度 {intensity}", text="一起做",  # noqa: E731
                                        steps=["S " + " ".join(f"{n}={v:g}" for n, v in goal.items())])
            self._start([goal] + self._eye_legs(name, intensity), additive=True, done=done)

    @staticmethod
    def _eye_legs(name, k):
        return [Frame(goal, speed, hold) for hold, speed, goal in eye_frames(name, k)]

    def tour(self, intensity, dwell=0.5):
        """7 个表情轮一遍，最后回 neutral 并放开，只留保持的舵机"""
        with self.lock:
            if self._busy():
                raise Refused("上一个动作还没结束")
            if intensity not in INTENSITIES:
                raise Refused("强度不对")
            active, legs = set(self.powered), []
            for name in list(EXPRESSIONS) + ["neutral"]:
                pose = self._pose(name, intensity, active)
                legs += [pose] + self._eye_legs(name, intensity)
                active |= set(pose)
            self._start(legs, additive=True, done=self._release_free, dwell=dwell)

    def _release_free(self):
        with self.lock:
            for board in list(self.links):
                kept = sorted(n for n in self.held if BY_NAME[n].board == board)
                self._ask(board, " ".join(["O"] + kept) if kept else "X")
            self.powered = set()
            self._record("cmd", board="all", cmd="放开，只留保持的舵机", reply="OK", angles=self.angles)

    def home(self, names=None):
        """已通电的舵机慢速回 90°。不用 O，O 是瞬跳"""
        with self.lock:
            if self._busy():
                raise Refused("上一个动作还没结束")
            active = self.powered if names is None else set(names)
            if not active or not active <= self.powered:
                raise Refused("没有通电的舵机")
            # 一条 S 只能发给一块板，所以按组走
            self._start([{n: center(n) for n in g if n in active} for _, g in GROUPS
                         if active & set(g)])

    def swing(self, amp):
        """90 → +A → 90 → -A → 90。+ 是 config 里 a 到 b 的方向，所以成对舵机自动镜像；超范围的截断"""
        with self.lock:
            if self._busy():
                raise Refused("上一个动作还没结束")
            if amp not in SWING_AMPS:
                raise Refused(f"幅度只能是 {SWING_AMPS}")
            if not self.powered or not any(self.powered <= set(g) for _, g in GROUPS):
                raise Refused("先通电，只能是同一组的舵机")
            if len({"JL", "JR"} & self.powered) == 1:
                raise Refused("下巴要成对摆动")
            names = sorted(self.powered)
            if any(abs(self.angles[n] - center(n)) > 0.5 for n in names):
                raise Refused("先回中心")
            mid = {n: center(n) for n in names}
            legs = []
            for sign in (1, -1):
                goal = {n: clip(n, center(n) + sign * direction(n) * amp) for n in names}
                if goal != mid:
                    legs += [goal, mid]
            if not legs:
                raise Refused("这一组两边都没有行程")
            self._start(legs)

    def power(self, names):
        self._check_enabled(names)
        if set(names) == self.powered:
            return self.home()
        with self.lock:
            if self._busy():
                raise Refused("上一个动作还没结束")
            if not any(set(names) <= set(g) for _, g in GROUPS):
                raise Refused("只能通同一组里的舵机")
            board = BY_NAME[names[0]].board
            self.held -= set(names)
            kept = lambda b: sorted(n for n in self.held if BY_NAME[n].board == b)  # noqa: E731
            for other in self.links:
                if other != board:
                    # 保持的舵机都在 90，O 不会让它们动
                    self._ask(other, " ".join(["O"] + kept(other)) if kept(other) else "X")
            self._ask(board, f"V {SPEED}")
            line = "O " + " ".join(list(names) + kept(board))
            reply = self._ask(board, line)
            if reply != "OK":
                raise Refused(reply)
            self.powered = set(names)
            self.error = ""
            self._read(board)
            self._record("cmd", board=board, cmd=line, reply=reply, angles=self.angles)
            # O 只能到 90，有实测中心的再慢速走过去
            off = {n: center(n) for n in names if center(n) != 90}
            if off:
                self._start([off])

    def hold(self, names):
        """让这些舵机一直保持在 90°，不受通别的组影响。S 90 只是通电，跟踪值已是 90 就不动"""
        self._check_enabled(names)
        with self.lock:
            if self._busy():
                raise Refused("上一个动作还没结束")
            if not names or any(n not in BY_NAME or n == "EXA" for n in names):
                raise Refused("未知或禁用的电机通道")
            if len({BY_NAME[n].board for n in names}) != 1:
                raise Refused("一次只能保持同一块板的舵机")
            if any(abs(self.angles[n] - 90) > 0.5 for n in names):
                raise Refused("先回 90°")
            board = BY_NAME[names[0]].board
            line = "S " + " ".join(f"{n}=90" for n in names)
            reply = self._ask(board, line)
            if reply != "OK":
                raise Refused(reply)
            self.held |= set(names)
            self.powered -= set(names)
            self._record("cmd", board=board, cmd=line, reply=f"保持 {reply}", angles=self.angles)

    def set_center(self, name):
        """把当前角度存成这个舵机的实测中心"""
        with self.lock:
            if self.mode == "sim":
                raise Refused("仿真不修改真实中心配置；直接调角度并保存表情即可")
            if self._busy():
                raise Refused("上一个动作还没结束")
            if name not in self.powered:
                raise Refused(f"{name} 没通电")
            deg = self.angles[name]
            self.save_center(name, deg)
            self._record("note", servo=name, status="info", text=f"实测中心设为 {deg:g}°")

    def move(self, deltas):
        self._check_enabled(deltas)
        with self.lock:
            if self._busy():
                raise Refused("上一个动作还没结束")
            off = [n for n in deltas if n not in self.powered]
            if off:
                raise Refused(f"{off} 还没通电")
            if any(abs(d) > MAX_STEP for d in deltas.values()):
                raise Refused(f"一步不能超过 {MAX_STEP}°")
            boards = {BY_NAME[n].board for n in deltas}
            if len(boards) != 1:
                raise Refused("一次只能动一块板")
            board = boards.pop()
            now = self._read(board)
            goal = {n: now[n] + d for n, d in deltas.items()}
            for n, v in goal.items():
                a = BY_NAME[n]
                if not min(a.a, a.b) <= v <= max(a.a, a.b):
                    raise Refused(f"{n}={v:g} 超出 config 范围 {min(a.a, a.b):g}–{max(a.a, a.b):g}")
            if {"JL", "JR"} & set(goal):
                jl, jr = goal.get("JL", now.get("JL")), goal.get("JR", now.get("JR"))
                if abs(jl + jr - 180) > JAW_SKEW:
                    raise Refused(f"下巴两侧偏差过大：JL={jl:g} JR={jr:g}，要成对动")
            self._ask(board, f"V {SPEED}")
            line = "S " + " ".join(f"{n}={v:g}" for n, v in goal.items())
            reply = self._ask(board, line)
            if reply != "OK":
                raise Refused(reply)
            time.sleep(self.settle)
            self._read(board)
            self._record("cmd", board=board, cmd=line, reply=reply, angles=self.angles)

    def track(self, on):
        """跟踪也是一个动作：跑着时别的按钮锁住，全部卸力能马上停"""
        if not on:
            return self._track_stop()
        with self.lock:
            if self._busy():
                raise Refused("上一个动作还没结束")
            if TRACK_SERVO not in self.powered:
                raise Refused(f"先给 {TRACK_SERVO} 通电")
            lim = load_verified(self.log_path).get(TRACK_SERVO)
            if lim is None:
                raise Refused(f"{TRACK_SERVO} 没有实测范围，先记录")
            try:
                params = self.vision("/params")["params"]
            except (OSError, ValueError, KeyError) as e:
                raise Refused(f"连不上视觉服务 {VISION_URL}，先启动 camera.web：{e}")
            self._ask(BY_NAME[TRACK_SERVO].board, f"V {SPEED}")
            self.stop.clear()
            self.tracking = {"face": False, "deg": self.angles[TRACK_SERVO], "lo": lim[0], "hi": lim[1]}
            self.job = threading.Thread(target=self._track_loop, daemon=True,
                                        args=(lim, params.get("gain", 1.0), params.get("hfov", 65.0)))
            self.job.start()

    def _track_stop(self):
        if self.tracking is None:
            raise Refused("视觉跟踪没开")
        self.stop.set()
        self.job.join(2)
        with self.lock:
            if TRACK_SERVO in self.powered:
                self._start([{TRACK_SERVO: center(TRACK_SERVO)}])

    def _track_loop(self, lim, gain, hfov):
        a = BY_NAME[TRACK_SERVO]
        lo, hi = lim
        deg = smooth = seen_lo = seen_hi = self.angles[TRACK_SERVO]
        home = min(hi, max(lo, center(TRACK_SERVO)))
        lost_at, fails = None, 0
        try:
            while not self.stop.wait(1 / TRACK_HZ):
                try:
                    v = self.vision("/state")
                    fails = 0
                except (OSError, ValueError) as e:
                    fails += 1
                    if fails >= 5:
                        raise Refused(f"视觉服务断开，跟踪已停止：{e}")
                    continue
                face = bool(v.get("face")) and v.get("x") is not None
                if face:
                    lost_at = None
                    goal = a.angle(gaze_to_u(v["x"], 0, gain, hfov)[0])
                else:
                    lost_at = lost_at or time.monotonic()
                    goal = home if time.monotonic() - lost_at > TRACK_LOST else smooth
                smooth += TRACK_ALPHA * (min(hi, max(lo, goal)) - smooth)
                if abs(smooth - deg) >= TRACK_DEADBAND:
                    deg = round(deg + max(-TRACK_STEP, min(TRACK_STEP, smooth - deg)), 1)
                    with self.lock:
                        if self.stop.is_set():
                            break
                        reply = self._ask(a.board, f"S {TRACK_SERVO}={deg:g}")
                        if reply != "OK":
                            raise Refused(reply)
                        self.angles[TRACK_SERVO] = deg
                    seen_lo, seen_hi = min(seen_lo, deg), max(seen_hi, deg)
                self.tracking = {**self.tracking, "face": face, "deg": deg}
        except Refused as e:
            self.error = str(e)
        finally:
            self.tracking = None
            # 10Hz 的命令不逐条写日志，只记走过的范围
            self._record("note", servo=TRACK_SERVO, status="info", text=f"视觉跟踪结束，走过 {seen_lo:g}~{seen_hi:g}°")

    def relax(self):
        # 一块板失败也要继续卸其他板
        self.stop.set()
        with self.lock:
            self.cal_epoch += 1
            errors = []
            for board in list(self.links):
                try:
                    if self._ask(board, "X") != "OK":
                        raise Refused(f"{board} 未确认卸力，请断开舵机 5V")
                except Refused as e:
                    errors.append(str(e))
            self.powered = set()
            self.held = set()
            self.script = None
            self._record("cmd", board="all", cmd="X", reply="; ".join(errors) or "OK", angles=self.angles)
            if errors:
                raise Refused("; ".join(errors))

    def note(self, servos, status, text):
        if status not in ("ok", "bad", "info"):
            raise Refused("状态不对")
        for s in servos:
            self._record("note", servo=s, status=status, text=text)

    def probe_llr(self, duration=1.0, epoch=None):
        """兼容空载检查：LLR 到 90°，默认 1 秒、最多 30 秒后卸力。"""
        duration = number(duration, "空载观察秒数", 0.2, 30)
        with self.lock:
            if epoch is not None and (type(epoch) is not int or epoch != self.cal_epoch):
                raise Refused("控制状态已改变，已取消过期的检查请求")
            if not self.llr_unloaded:
                raise Refused("尚未启用 LLR 拆舵盘空载检查")
            if self._busy() or self.powered or self.held:
                raise Refused("请先全部卸力，等待当前动作结束")
            if "mouth" not in self.links:
                raise Refused("mouth 板不在线")
            self.stop.clear()
            self.cal_epoch += 1
            self.error = ""
            self.llr_probe = f"检查中：90°，{duration:g} 秒后卸力"
            self.job = threading.Thread(target=self._probe_llr, args=(duration,), daemon=True)
            self.job.start()

    def _probe_llr(self, duration):
        try:
            with self.lock:
                if self.stop.is_set():
                    return
                # 清理所有板子可能残留的输出；唯一通电命令固定为 O LLR。
                for board in list(self.links):
                    if self._ask(board, "X") != "OK":
                        raise Refused(f"{board} 未确认卸力，取消检查")
                self._record("probe", servo="LLR", phase="start", angle=90, duration=duration,
                             text="用户触发拆舵盘空载检查，不代表机械验收通过")
                if self._ask("mouth", "O LLR", unloaded_probe=True) != "OK":
                    raise Refused("LLR 未接受检查命令")
                self.powered.add("LLR")
            self.stop.wait(self.pace * duration)
        except (Refused, OSError, ValueError) as e:
            self.error = str(e)
        finally:
            with self.lock:
                try:
                    if self._ask("mouth", "X") != "OK":
                        raise Refused("mouth 未确认卸力，请断开 5V")
                    self.llr_probe = "已卸力；请记录是否有声音、抖动或发热"
                except Refused as e:
                    self.error = f"{e}；请断开舵机 5V"
                    self.llr_probe = "无法确认卸力，请断开 5V"
                self.powered.discard("LLR")
                try:
                    self._record("probe", servo="LLR", phase="end", error=self.error,
                                 cancelled=self.stop.is_set())
                except OSError as e:
                    self.error = f"检查日志写入失败：{e}"

    def set_range(self, servo, lo, hi):
        with self.lock:
            if self._busy():
                raise Refused("请等动作停止后再记录范围")
            if servo not in BY_NAME or servo == "EXA":
                raise Refused("未知或禁用的电机通道")
            a = BY_NAME[servo]
            lo = number(lo, "实测下限", min(a.a, a.b), max(a.a, a.b))
            hi = number(hi, "实测上限", min(a.a, a.b), max(a.a, a.b))
            if lo >= hi:
                raise Refused("下限要小于上限")
            self._record("range", servo=servo, lo=lo, hi=hi)

    def pose(self, name, text):
        if not self.powered:
            raise Refused("没有通电的舵机，没有可记录的姿态")
        kvs = " ".join(f"{n}={self.angles[n]:g}" for n in sorted(self.powered))
        self._record("recipe", name=name, text=text, steps=[f"S {kvs}"])

    def enable_group(self, names):
        """加入一组，已有电机保持原角度；不用会卸掉其他电机的 O 命令。"""
        self._check_enabled(names)
        with self.lock:
            if self._busy():
                raise Refused("上一个动作还没结束")
            if not names or not any(set(names) == set(g) for _, g in GROUPS):
                raise Refused("请选择完整的一组电机")
            board = BY_NAME[names[0]].board
            now = self._read(board)
            goal = validate_angles({n: now[n] for n in names})
            self._check_ranges(goal)
            line = "S " + " ".join(f"{n}={v:g}" for n, v in goal.items())
            self._ask(board, f"V {SPEED}")
            if self._ask(board, line) != "OK":
                raise Refused(f"{board} 未接受通电命令")
            self.powered |= set(names)
            self.held -= set(names)
            self.error = ""
            self._record("cmd", board=board, cmd=line, reply="加入标定", angles=dict(self.angles))

    def _check_ranges(self, goal):
        verified = load_verified(self.log_path)
        for n, value in goal.items():
            if n in verified and not verified[n][0] <= value <= verified[n][1]:
                raise Refused(f"{n}={value:g} 超出已记录实测范围 {verified[n]}")

    def save_expression(self, label, revision, title="", text=""):
        with self.lock:
            if self._busy() and not self._cal_at_goal():
                raise Refused("请等动作停止后再保存")
            active = self.powered | self.held
            self._check_enabled(active)
            if not active:
                raise Refused("请先加入电机组并调整姿态")
            for board in {BY_NAME[n].board for n in active}:
                self._read(board)
            angles = {n: self.angles[n] for n in sorted(active)}
            self._check_ranges(angles)
            pose = self.library.save(label, angles, title, text, revision)
            self.preview = None
            self._record("calibration", label=label_key(label), revision=self.library.data["revision"], **pose)

    def load_expression(self, label, intensity=1.0):
        """只加载预览。不会打开串口、通电或移动。"""
        with self.lock:
            goal = self.library.resolve(label, intensity)
            self._check_enabled(goal)
            self._check_ranges(goal)
            self.preview = {"label": label_key(label), "intensity": intensity, "angles": goal,
                            "unverified": sorted(set(goal) - load_verified(self.log_path).keys()),
                            "revision": self.library.data["revision"]}

    @staticmethod
    def _transition(start, goal, seconds):
        # 每 50 ms 最多改 5°；较大位移自动延长过渡。原始角度不再加中心偏移。
        duration = max(seconds, max(abs(v - start[n]) for n, v in goal.items()) / 100)
        count = max(1, math.ceil(duration / 0.05))
        return [Frame({n: round(start[n] + (v - start[n]) * i / count, 3) for n, v in goal.items()},
                      SPEED, duration / count) for i in range(1, count + 1)]

    def emotion(self, label, intensity=1.0, transition=1.0, hold=None, revision=None):
        """标签调用与页面重放共用唯一串口所有者。hold=None 保持，数值则到时回 neutral。"""
        transition = number(transition, "过渡秒数", 0.2, 10)
        if hold is not None:
            hold = number(hold, "保持秒数", 0, 30)
        with self.lock:
            if self._busy():
                raise Refused("当前有动作或跟踪任务，请等待完成或先卸力")
            if revision is not None and revision != self.library.data["revision"]:
                raise Refused("表情库已更新，请重新加载预览")
            goal = self.library.resolve(label, intensity)
            self._check_enabled(goal)
            self._check_ranges(goal)
            outside = (self.powered | self.held) - goal.keys()
            if outside:
                raise Refused(f"基准之外还有通电通道 {sorted(outside)}，请先全部卸力")
            for board in {BY_NAME[n].board for n in goal}:
                self._read(board)
            start = validate_angles({n: self.angles[n] for n in goal})
            self._check_ranges(start)
            legs = self._transition(start, goal, transition)
            if hold is not None:
                neutral = self.library.resolve("neutral")
                self._check_ranges(neutral)
                legs += [Frame(goal, SPEED, hold)] + self._transition(goal, neutral, transition)
            self.held -= goal.keys()
            self.preview = None
            self.error = ""
            def done():
                with self.lock:
                    if not self.stop.is_set():
                        self._record("replay", label=label_key(label), intensity=intensity, transition=transition,
                                     hold=hold, revision=self.library.data["revision"])
            self._start(legs, additive=True, done=done)

    def state(self):
        return {
            "stamp": time.monotonic_ns(),
            "groups": [{"label": label, "names": names} for label, names in GROUPS],
            "limits": {n: [min(a.a, a.b), max(a.a, a.b)] for n, a in BY_NAME.items()},
            "angles": self.angles,
            "powered": sorted(self.powered),
            "held": sorted(self.held),
            "script": self.script,
            "expressions": list(EXPRESSIONS),
            "centers": {n: center(n) for n in BY_NAME},
            "boards": sorted(self.links),
            "dirs": {n: direction(n) for n in BY_NAME},
            "busy": self._busy(),
            "tracking": self.tracking,
            "error": self.error,
            "mode": self.mode,
            "blocked": dict(self.blocked),
            "llr_unloaded": self.llr_unloaded,
            "llr_probe": self.llr_probe,
            "library": self.library.summary(),
            "preview": self.preview,
            "calibration": self.calibration_state(),
            "servo_boards": {n: a.board for n, a in BY_NAME.items()},
            "verified_ranges": load_verified(self.log_path),
        }


WEB = ROOT / "head" / "web"
PAGE = (WEB / "calibration.html").read_text()


def make_handler(bench):
    class Handler(BaseHTTPRequestHandler):
        def log_message(self, *a):
            pass

        def _send(self, code, body, ctype):
            self.send_response(code)
            self.send_header("Content-Type", ctype)
            self.send_header("Content-Length", str(len(body)))
            self.send_header("Cache-Control", "no-store")
            self.end_headers()
            self.wfile.write(body)

        def do_GET(self):
            if self.path == "/":
                return self._send(200, PAGE.encode(), "text/html; charset=utf-8")
            if self.path in ("/calibration.css", "/calibration.js"):
                mime = "text/css" if self.path.endswith(".css") else "text/javascript"
                return self._send(200, (WEB / self.path[1:]).read_bytes(), mime + "; charset=utf-8")
            if self.path == "/positions.json":
                with bench.lock:
                    body = json.dumps(bench.positions.export(), ensure_ascii=False, allow_nan=False).encode()
                return self._send(200, body, "application/json; charset=utf-8")
            if self.path in ("/state", "/expressions.json"):
                with bench.lock:
                    data = bench.state() if self.path == "/state" else bench.library.export()
                    body = json.dumps(data, ensure_ascii=False, allow_nan=False).encode()
                return self._send(200, body, "application/json; charset=utf-8")
            self._send(404, b"{}", "application/json")

        def do_POST(self):
            # 自定义头让别的网页没法跨站发命令
            if self.path != "/api" or self.headers.get("X-Head") != "1":
                return self._send(403, b"{}", "application/json")
            out = {}
            status = 200
            try:
                size = int(self.headers.get("Content-Length", "0"))
                if not 0 < size <= 65536:
                    raise Refused("请求大小需要在 1–65536 字节之间")
                req = json.loads(self.rfile.read(size))
                if not isinstance(req, dict):
                    raise Refused("请求必须是 JSON 对象")
                op = req.pop("op")
                if op != "state":
                    {"power": bench.power, "move": bench.move, "relax": bench.relax, "note": bench.note,
                     "range": bench.set_range, "pose": bench.pose, "home": bench.home, "swing": bench.swing, "hold": bench.hold,
                     "expr": bench.expr, "expr_next": bench.expr_next, "expr_all": bench.expr_all,
                     "expr_go": bench.expr_go, "tour": bench.tour,
                     "set_center": bench.set_center, "track": bench.track,
                     "enable_group": bench.enable_group, "save_expression": bench.save_expression,
                     "load_expression": bench.load_expression, "emotion": bench.emotion,
                     "probe_llr": bench.probe_llr,
                     "cal_begin": bench.cal_begin, "cal_touch": bench.cal_touch,
                     "cal_stop": bench.cal_stop,
                     "cal_target": bench.cal_target, "cal_range": bench.cal_range,
                     "cal_capture": bench.cal_capture, "cal_restore": bench.cal_restore}[op](**req)
            except (Refused, PoseError, ValueError, KeyError, TypeError, IndexError, OSError) as e:
                out["error"] = str(e)
                status = 400
            with bench.lock:
                out["state"] = bench.state()
                body = json.dumps(out, ensure_ascii=False, allow_nan=False).encode()
            self._send(status, body, "application/json; charset=utf-8")

    return Handler


def main():
    parser = argparse.ArgumentParser(description="逐组标定、保存表情、按情绪标签重放")
    parser.add_argument("--sim", action="store_true", help="只用内存串口，保存到独立仿真库")
    parser.add_argument("--port", type=int, default=PORT)
    parser.add_argument("--library", type=Path, help="表情库 JSON 路径；重启使用同一路径即可恢复")
    parser.add_argument("--log-file", type=Path)
    parser.add_argument("--llr-unloaded", action="store_true", help="已确认 LLR 拆下舵盘：允许用户触发 90° / 1 秒空载检查")
    args = parser.parse_args()
    path = args.library or (ROOT / "outputs" / "calibration-sim" / "expressions.json" if args.sim else DEFAULT_PATH)
    log_path = args.log_file or (ROOT / "outputs" / "tune_sim.jsonl" if args.sim else LOG)
    # 配置损坏先报错，不先占用串口。
    PoseLibrary(path, mode="sim" if args.sim else "hardware")
    PositionBook(path.with_name(path.stem + "-positions.json"), mode="sim" if args.sim else "hardware")

    def log(entry):
        log_path.parent.mkdir(parents=True, exist_ok=True)
        with log_path.open("a") as f:
            f.write(json.dumps(entry, ensure_ascii=False, allow_nan=False) + "\n")

    if args.sim:
        from head.sim_serial import SimSerial
        links = {b: SimSerial(b) for b in BOARDS}
    else:
        links = discover()
    bench = Bench(links, log=log, rediscover=None if args.sim else discover,
                  library_path=path, mode="sim" if args.sim else "hardware", llr_unloaded=args.llr_unloaded)
    bench.log_path = log_path
    print(f"{'仿真' if args.sim else '真机'} · 在线: {sorted(bench.links)} · http://127.0.0.1:{args.port}", flush=True)
    print(f"表情库: {path}", flush=True)
    closing = threading.Event()

    def heartbeat():
        while not closing.wait(1):
            try:
                bench.beat()
            except Exception as e:
                bench.error = f"心跳出错：{e}"

    threading.Thread(target=heartbeat, daemon=True).start()
    import signal
    def shutdown(signum, frame):
        raise KeyboardInterrupt
    signal.signal(signal.SIGTERM, shutdown)
    server = None
    try:
        server = ThreadingHTTPServer(("127.0.0.1", args.port), make_handler(bench))
        server.serve_forever()
    except KeyboardInterrupt:
        pass
    finally:
        closing.set()
        try:
            bench.relax()
        finally:
            for link in list(bench.links.values()):
                link.close()
            if server:
                server.server_close()


if __name__ == "__main__":
    main()
