letteryzzm/emotionbot/(commit log)

2026-11-05 导入机器人头项目：固件、电脑端、PCB、情感模块和文档
    基于 Will Cogley Robot Head α2.0.33（CC BY-NC-SA 4.0）。
    脚本路径改成相对路径，文档放进 docs/，大文件走 Release。
    [Eyeball_官方_x2.stl, NeckStand_颈部支架_x1.stl, ProDoc_Eyes_Brow_Neck_2025-04-16.epro, ProDoc_Mouth Board_2025-04-16.epro, ServoSizingPlate_舵机尺寸测试块_x1.stl, TopLidHorn_眼皮舵盘_x3.stl, 立创商城BOM_3块板合计.csv, 立创商城_BOM配单.csv]
2026-11-05 docs：加入调研报告和论文精读
2026-11-05 补充装配配图、电源线焊接流程和上游链接
    - 组装流程：图 8 连杆对照、图 9 关节和 M3 螺母说明、图 15 眉毛结构
    - 新增电源线焊接流程和舵机测试接线图
    - 螺丝清单加入眉毛用量，README 加入上游 GitHub 仓库
2026-11-06 舵机接线、嘴部交接和组装流程更新
    - 新增接线与上电检查页、下巴和嘴部测试交接文档
    - 按实际位置修正 L/R：眼皮、眉毛、下颌和嘴唇、嘴角的左右定义不同
    - 对调 LLL/LLR 的 a/b，修正表情映射、预览和组装图标注
    - 新增 servo_step.py；servo_check 让 JL/JR 一起转；表情 demo 支持小强度
    - Linux 只按 MicroPython by-id 找 Pico，不碰其他串口
    - 重排组装流程，加入封口后盖的生成脚本
    [actuators.py, blendshape_map.py, brow_fig.py, build_steps.py, client.py, config_brows.py, config_eyes.py, config_mouth.py]
2026-11-06 固件改为上电不发信号，加入逐个舵机测试和协议测试记录
    - firmware：启动时不输出舵机信号，O 命令只给列出的舵机上电，X 全部卸力
    - servo_step / servo_check：支持逐个舵机检查，JL/JR 成对镜像
    - 文档：交接流程改用 ROG 共用目录 /srv/robot-head，新增协作者的协议测试记录
2026-11-06 head：串口发现兼容 Windows/Linux，Pico 启动期重试
2026-11-06 feat：加入感知、决策与运行时闭环（perception/agent/app）
2026-11-06 test：补齐感知、决策和闭环测试
2026-11-06 scripts：环境自检、模型下载、彩排和 T5 回显工具
2026-11-06 docs：开发日志、计划、项目思路和队友接口
2026-11-06 docs：摄像头与 T5 联调测试记录
2026-11-10 docs: 重整灵眸项目 README、演示素材与联调导航
2026-11-10 feat: 保存灵眸视觉、戏台、T5 与真机调试实现
2026-11-10 docs: 确定无 T5 上位机架构与实验模型方案
2026-11-11 feat: persist calibrated expressions and replay by emotion label
2026-11-11 fix: quarantine noisy LLR servo in calibration controls
    [tune_server.py]
2026-11-13 Rebuild servo calibration panel with slow manual exploration and observations
2026-11-13 Allow direct manual servo adjustment without observation gates
2026-11-13 Restore normal LLR calibration controls at user request
